Chamadreja/pps-solar-charger/investigacion/Bateria/eleccion de bateria.docx

Requerimientos: Se busca una batería robusta, de larga vida útil, siendo esta de almenos 500 ciclos, con el menor tiempo de carga posible. El Tamaño no es un factor decisivo, sin embargo, se valorará una dimensión reducida a fines de mejorar la estética y portabilidad. Se tendrá en cuenta el valor respecto de sus pares. Que provea una tensión de alimentación de al menos 5V y una capacidad de 10 ah o superior. Estos valores son considerados pensando en un escenario desfavorable, en el cual mi panel está inactivo por un tiempo prolongado y nuestra batería debe poder mantener el circuito funcionando (una estimación del mayor consumo es de 1.2 Ah). De esta forma nos aseguramos el funcionamiento de la estación base por una semana, considerando una batería llena sin alimentación externa. Es válido usar una configuración serie o paralela para poder cumplir con los requisitos. El Ah tiene una base de 20 hs.

A continuación, se expresa un cuadro comparando un promedio de las principales características que tienen los tipos de batería más conocidos

Tipo | Voltaje por elemento y corriente pilas tipo AA | Vida útil (n° recargas) | Densidad energía (Wh/Kg) | Tiempo de carga (horas) | observación
Acido plomo | 2 V | 1000 | 30-40 | 8-16 | Bajo costo No admiten sobrecargas ni descargas por debajo del 50% (reduce mucho la vida útil) Escalabilidad reducida para adjuntar nuevas baterias, en función de la configuración y tiempo de vida que tengan Eficiencia de carga entre 80% y 85 % No pueden funcionar acostadas Contaminan Requieren mantenimiento Peso excesivo
Níquel hierro (Ni-Fe) | 1.2 a 1.4 V | +10000 | 30-55 | 4-8 | Pésimo rendimiento (eficiencia de 65%) No tiene efecto memoria, lo que da una gran vida útil (superior a 100 años) Admite sobrecargas, repetidas descargas totales e incluso cortocircuitos sin pérdida significativa de capacidad
níquel-cadmio (Ni-Cd) | 1.2 V 0,5 a 1,0 A | 500 | 48-80 | 10-14 | Admiten un gran rango de temperaturas de funcionamiento. Admiten sobrecargas, se pueden seguir cargando cuando ya no admiten más carga, aunque no la almacenan. Efecto memoria muy alto. Densidad de energía baja.
níquel-hidruro metálico (Ni-MH) | 1,2 V 0,5 a 2,8 A | 1000 | 60-120 | 2-4 | Efecto memoria bajo No admiten bien el frío extremo, reduciendo drásticamente la potencia eficaz que puede entregar.
Litio (Li-ION) | máxima 4,3 V Nominal 3,6 baja 2,65 V (no es limitante) 1,5 a 2,8 A | 4000 | 110-160 | 2-4 | Mayor costo Enorme densidad energética, muy livianas, tamaño pequeño, Buen rendimiento, cercano al 100% Bajo efecto memoria Inflamables Facilidad para aumentar la capacidad o características eléctricas Muy sensibles a descarga completa instantánea Toleran un amplio rango de temperatura Tiempo de carga rápido No requieren mantenimiento Mantienen un voltaje estable al descargarse Vida útil de 3 años
Litio Ferrofosfato (LiFePO4) | Máximo 3.65 Nominal 3 Baja 2.5 V | 7000 o mas | 90 | 0.5 | Mantiene su voltaje constante mientras se descarga Liviana y compacta Mayor costo Buena durabilidad Destaca por su seguridad, usadas en aplicaciones medicas, aeronáuticas, etc
Litio (LiPo) | Máximo 4.2 V nominal 3,7 V y mínimo 3,0 V | 5000 | 100-130 | 1-1,5 | Mayor densidad de energía y mejor tasa de descarga, que LI-ION. Si se descargan por debajo del 30% (3V.) quedan inutilizables Baterias de celular Inflamables
Gel AGM | 1.6 – 1.8 V | 200 a 1000 | 40 ? | 10 | Son una batería de ácido plomo modificada, esta el electrolito se encuentra en un estado de gel o gaseoso Vida útil 12 años Sellamiento hermético, puede utilizarse en cualquier posición No requieren mantenimiento Soportan temperaturas extremas Voltaje variable en función de la carga Contaminan

El efecto memoria es un efecto no deseado que afecta a las baterías y por el cual en cada recarga se limita el voltaje o la capacidad (a causa de un tiempo largo, una alta temperatura, o una corriente elevada). La consecuencia es la reducción de su capacidad para almacenar energía.

Las baterías de níquel se pueden cargar hasta en 30 minutos, con cargas rápidas, pero disminuye su vida y se calientan en exceso, siendo las únicas que admiten este tipo de cargas.

Conclusión: Optamos por utilizar una batería plomo ácido de gel, también denominadas sla o vrla, debido a que presenta una buena vida útil respecto de sus pares, toleran un alto rango de temperaturas, lo cual es crucial ya que la capacidad de se ve fuertemente disminuida con la temperatura. Son robustas y cumplen con nuestros requerimientos eléctricos. Las baterías de litio fueron seriamente consideradas, debido a que presentan ventajas en números aspectos sobre, tales como tolerancia a las temperaturas, fiabilidad, posibilidad de escalabilidad, vida útil. Sin embargo, fueron descartadas debido a que su precio es considerablemente más elevado y su rango inferior de temperatura para ser cargada es un poco más alto.

Nombre -Fabricante | Distribuidor | Características | Precio En dólares | Datasheet
BGH-690F2 Battery guy | Digikey | 6V 9Ah AGM Temperatura carga sin especificar | 32 | https://batteryguy.com/files/technical-docs/tech-spec-sheets/bgh-690f2-technical-specification-sheet.pdf
BW 6140 Bright Way Group | Digikey | 6v 14 Ah AGM Temperatura carga -10° a 50° | 29 | https://media.digikey.com/pdf/Data%20Sheets/Bright%20Way%20Group/BWG_Spec_Sheet_BW%206140.pdf
PS-6100 Power Sonic | Digikey | 6v 12 Ah AGM Temperatura carga -15° a 50° | 28 | https://www.power-sonic.com/wp-content/uploads/2018/12/PS-6100%20technical%20specifications.pdf
BP33-6-B1 B B Battery | Digikey | 6V 33 Ah AGM Temperatura carga 0° a 40° | 120 | http://www.bb-battery.com/global/show.php?f=BP33-6.pdf.d8a36eda4faaf028dc24dfe75d7caaf6&m=BP33-6.pdf
BP10-6-T1 B B Battery | Digikey | 6V 10 Ah AGM Temperatura carga 0° a 40° | 17.5 | http://www.bb-battery.com/global/show.php?f=BP10-6.pdf.06ace2856471720bfb7fbd8f4346005c&m=BP10-6.pdf
PC12-6XBF1 Zeus Battery Products | Digikey | 5.25V 10 Ah AGM Temperatura carga 0° a 45° | No carga la página | https://www.zeusbatteryproducts.com/wp-content/uploads/downloads/ZEUS_SPEC_SHEET_PC12-6XB_RevV2.pdf
BW 6140 Bright Way Group | Digikey | 6V 14 Ah AGM Temperatura carga -10° a 50° | 29.7 | https://media.digikey.com/pdf/Data%20Sheets/Bright%20Way%20Group/BWG_Spec_Sheet_BW%206140.pdf

Electrocomponentes y elemon aparentemente no vende baterías o no estamos buscando bien
Mouse tiene disponibilidad, pero no arroja precios

Nombre -Fabricante | Distribuidor | Características | Precio En dólares | Datasheet
PRT-11856 Sparkfun Electronics | Digikey | 7.4 V 2.2 Ah | 15.95 | https://media.digikey.com/pdf/Data%20Sheets/Sparkfun%20PDFs/PRT-11856_Web.pdf
DTP605068-3P Sparkfun electronics | Digikey | 3.7V/ 6Ah Temperatura carga -0° a 45° | 29.95 | https://cdn.sparkfun.com/datasheets/Prototyping/spe-00-DTP605068-3P-6000mah-en-1.0ver.pdf
PRT-12895 SparkFun Electronics | Digikey | 3.7 V 2.6Ah Temperatura carga -0° a 45° | 5.95 | https://cdn.sparkfun.com/datasheets/Prototyping/ICR18650%202600mAH%20datasheet.pdf
PIS-1131 Pi Supply | Digikey | 3.7 V 5Ah Temperatura carga sin especificar | 43.66 | https://cdn.shopify.com/s/files/1/2187/3161/files/PIS-1131_5000mAh_PiJuice_Battery.pdf
BL2200F6034501S2PZAL GlobTek, Inc. | Digikey | 3.7 V 2Ah Temperatura carga 0° a 45 | 17 | https://www.globtek.com/pdf/manual-datasheets/BL2200F6034501S2PZAL.pdf
LI18650PBF 2S2P Jauch Quartz | Digikey | 7.2V 6.5AH Temperatura carga 0° a 45 | 51 | https://www.jauch.com/downloadfile/5bf56df1aa4563344c66752e0b062d553/6700mah_-_li18650jp_2s2p_2_wires_70mm.pdf
RJD3555HPPV30M Illinois Capacitor | Digikey | 3V 5Ah Temperatura carga 0° a 45 | 29 | https://media.digikey.com/pdf/Data%20Sheets/Illinois%20Cap/RJD_Series_Rev2016.pdf
LION-1865-34 Ultralast | Digikey | 3.7V 3.4AH Temperatura carga sin especificar | 12 | https://www.digikey.com/en/products/detail/ultralast/LION-1865-34/13692714
ICR18650 PKCELL | Digikey | 4.4Ah 3.7V Temperatura carga -0° a 45° | 20 | https://cdn-shop.adafruit.com/product-files/354/C449_-_ICR18650_4400mAh_3.7V_with_PCM_20140728_APPROVED_8.18.pdf

Se elige la batería PS-6100 de Power Sonic debido a que tolera cargas en temperaturas inferiores a la de sus pares. Este factor es determinante ya que en zonas, no muy lejanas a Bariloche, las temperaturas pueden llegar fácilmente a -20°C o incluso menos.

En cuanto a las temperaturas de operación, se prevé diseñar algún sistema de refrigeración cuando estas estén llegando al máximo descrito por el fabricante, mientras que para solventar aquellas situaciones donde la temperatura esté por debajo del margen tolerable, contaremos con cierta estructura que aislará nuestro circuito del medio, además de que cuando el panel comienza a recibir energía solar, se supone que se ganaron algunos grados de temperatura comparados con los mínimos registrados.
