Chamadreja/pps-solar-charger/investigacion/Cargador/subsistema carga bateria.docx

Previamente en el informe global deberá estar definido, zona de operación, tiempo de funcionamiento y alguna otra característica que no se me viene a la mente en el momento

introducción al subsistema

Este subsistema es de crucial importancia, debido a que si este falla o no funciona correctamente, todos los otros subsistemas fallaran.

Se prevé diseñarlo a partir de tres componentes, siendo estos: batería, cargador y un panel solar.

La batería estará alimentando la totalidad de la estación base de forma continua. El cargador será responsable de monitorear la capacidad de la misma y gestionar su carga de manera correcta, a través de la energía provista por un panel solar, aunque también será posible realizar la carga mediante otro suministro eléctrico, como la corriente de red.

Para elegir los componentes se utilizó la misma metodología en todos, siendo esta, definir los requisitos que deben cumplir en primera instancia. Luego realizar una investigación sobre las distintas clases de componentes que existen, para realizar una buena elección utilizamos un sistema de puntuación. Una vez definida la clase, se realizó un estudio de mercado sobre los distintos productos que ofrecen los principales distribuidores. Finalmente, sobre estos, se realizó una nueva elección, en busca del componente optimo par nuestro proyecto

Batería

Requerimientos: Se busca una batería robusta, de larga vida útil, siendo esta de al menos 400 ciclos, con el menor tiempo de carga posible. El tamaño no es un factor decisivo, sin embargo, se valorará una dimensión reducida a fines de mejorar la estética y portabilidad. Que posea un rango de temperatura de acorde a línea sur. Se tendrá en cuenta el valor monetario respecto de sus pares. Que provea una tensión de alimentación de al menos 5V y una capacidad de 10 Ah o superior. Es válido usar una configuración serie o paralela para poder cumplir con los requisitos.

Acerca de los valores de temperatura, la temperatura de carga, siempre es menor que la temperatura de operación. Por lo tanto, esta es la limitante y en la cual nos basaremos. En la línea sur se registran temperaturas entre -30 °C y 35 °C grados. Decidimos que una temperatura de carga entre -10 °C y 40 °C será suficiente, si bien no cumplimos con la mínima. Esto no será un problema, debido a que nuestro sistema de carga funcionara cuando salga el sol, esto significa que la temperatura ambiente subirá unos grados respecto de la mínima, además estará al resguardo de la intemperie y el propio calor generado a partir del funcionamiento aumentaran aún más la temperatura.

Los valores eléctricos son definidos a partir de la tensión necesaria para el correcto funcionamiento de todos los componentes eléctricos y bajo la posibilidad de un escenario desfavorable, en el cual no se dispone de energía para cargar la batería por un tiempo prolongado y esta debe mantener el circuito funcionando

Una estimación del mayor consumo posible es la estación base es de 1.1 Ah. Por lo tanto, aseguramos el funcionamiento de la estación base por al menos 9 días, considerando una batería llena sin alimentación externa. En la tabla 4 y tabla 5 quedan detallados los consumos de cada componente

Cabe destacar que estos valores son aproximados, debido a que es algo teórico y no sabe a ciencia cierta el protocolo de comunicación que será utilizado, además de que las baterías pierden tensión en función de su carga. Realmente la batería está sobredimensionada, debido a que nunca tendremos nuestra estación base operando a toda su capacidad por periodos prolongados de tiempo, lo que significa que en verdad podremos funcionar todavía más tiempo, sin recargar la batería

Según la bibliografía el Ah tiene distintas bases de tiempo, tomaremos una de 20 hs en nuestro caso. Esto significa que una batería de 1 Ah tiene la capacidad de proveer 1 A durante 20 horas

Componente | consumo nominal (mAh) | Voltaje de operación típico (V) | Corriente Máxima (mA) | Vida útil (años)
módulo ESP 32 W-ROOM | 40 | 3.6 | 1200 | 12
SIM 800L | Reposo: 0.7 Transmisión: 500 | 4 | 500 | 4
módulo LoRa a definir | Reposo: 1.5 Recepción: 11.5 | 3.3 | transmisión 120 | 4.5
GPS NEO-6M | 30 | 3.3 | 100 | sin especificar
Totales y máximos | promedio 83 | máximo 4 V | máximo 1920

Tabla 4

El consumo máximo es irreal, debido a que nuestra estación base, jamás requerirá que el esp32 opere al 100%, a la vez que transmite datos con mediante el SIM800l y el GPS. Por lo tanto, se realizaron cuentas en base a un caso máximo real

Descripción | Consumo (mA)
Tranmision SIM800l | 500
Tranmsiion GPS 6M-NEO | 100
Funcionamiento y recepción LoRa | 11.5
Funcionamiento ESP32 W-ROOM con WIFI y BLE activados | 390
Sistema de carga | 100
TOTAL | 1101.5

Tabla 5

Elección tipo de batería

En la tabla 6 se comparan los principales tipos de baterías

Tipo | Voltaje por elemento y corriente pilas tipo AA | Vida útil (n° recargas) | Densidad energía (Wh/Kg) | Tiempo de carga (horas) | observación
Acido plomo | 2 V | 1000 | 30-40 | 8-16 | Bajo costo No admiten sobrecargas ni descargas por debajo del 50% (reduce mucho la vida útil) Escalabilidad reducida para adjuntar nuevas baterías, en función de la configuración y tiempo de vida que tengan Eficiencia de carga entre 80% y 85 % No pueden funcionar acostadas Contaminan Requieren mantenimiento Peso excesivo
Níquel hierro (Ni-Fe) | 1.2 a 1.4 V | +10000 | 30-55 | 4-8 | Pésimo rendimiento (eficiencia de 65%) No tiene efecto memoria, lo que da una gran vida útil (superior a 100 años) Admite sobrecargas, repetidas descargas totales e incluso cortocircuitos sin pérdida significativa de capacidad
níquel-cadmio (Ni-Cd) | 1.2 V 0,5 a 1,0 A | 500 | 48-80 | 10-14 | Admiten un gran rango de temperaturas de funcionamiento. Admiten sobrecargas, se pueden seguir cargando cuando ya no admiten más carga, aunque no la almacenan. Efecto memoria muy alto. Densidad de energía baja.
níquel-hidruro metálico (Ni-MH) | 1,2 V 0,5 a 2,8 A | 1000 | 60-120 | 2-4 | Efecto memoria bajo No admiten bien el frío extremo, reduciendo drásticamente la potencia eficaz que puede entregar. Unicas q
Litio (Li-ION) | máxima 4,3 V Nominal 3,6 baja 2,65 V (no es limitante) 1,5 a 2,8 A | 4000 | 110-160 | 2-4 | Mayor costo Enorme densidad energética, muy livianas, tamaño pequeño, Buen rendimiento, cercano al 100% Bajo efecto memoria Inflamables Facilidad para aumentar la capacidad o características eléctricas Muy sensibles a descarga completa instantánea Toleran un amplio rango de temperatura Tiempo de carga rápido No requieren mantenimiento Mantienen un voltaje estable al descargarse Ante descarga profunda, se recuperan suministrando corriente constante durante la primer etapa y a voltaje constante durante toda la carga Vida útil de 3 años
Litio Ferrofosfato (LiFePO4) | Máximo 3.65 Nominal 3 Baja 2.5 V | 7000 o más | 90 | 0.5 | Mantiene su voltaje constante mientras se descarga Liviana y compacta Mayor costo Buena durabilidad Destaca por su seguridad, usadas en aplicaciones médicas, aeronáuticas, etc
Litio (LiPo) | Máximo 4.2 V nominal 3,7 V y mínimo 3,0 V | 5000 | 100-130 | 1-1,5 | Mayor densidad de energía y mejor tasa de descarga, que LI-ION. Si se descargan por debajo del 30% (3V.) quedan inutilizables Baterias de celular Inflamables
Gel AGM | 1.6 – 1.8 V | 200 a 1000 | 40 ? | 10 | Son una batería de ácido plomo modificada, el electrolito se encuentra en un estado de gel o gaseoso Vida útil 12 años Sellamiento hermético, puede utilizarse en cualquier posición No requieren mantenimiento Soportan temperaturas extremas Voltaje variable en función de la carga Contaminan Ante descarga profunda, debe recuperarse respetando los ciclos de carga

Tabla 6

Referencia para entender la tabla, lo deberíamos poner? De ser asi, como ¿

El efecto memoria es un efecto no deseado que afecta a las baterías y por el cual en cada recarga se limita el voltaje o la capacidad (a causa de un tiempo largo, una alta temperatura, o una corriente elevada. La consecuencia es la reducción de su capacidad para almacenar energía.

Conclusión: Optamos por utilizar una batería plomo ácido AGM, también denominadas sla o vrla, debido a que presenta una buena vida útil respecto de nuestros requerimientos, tiene uno de los mayores rango de temperatura para una carga correcta , lo cual es crucial para mantener mi sistema funcional. Son robustas y cumplen con nuestros requerimientos eléctricos. Un detalle negativo de estas, es que el voltaje varía en función de la capacidad de la misma, es por esto que usaremos una batería cuyo voltaje sea superior a los que requiere mi circuito, a modo de compensar la caída de tensión. Respecto al tiempo de carga no parece ser el mejor en las tablas, sin embargo, considerando que, para lograr una misma capacidad con otras baterías, por ejemplo, de ION-litio debo configurar varias de ellas en paralelo, el tiempo de carga individual se verá aumentado en función de la cantidad de baterías que tenga, lo que resulta en tiempos de carga similares

Las baterías de litio fueron seriamente consideradas, debido a que presentan ventajas en números aspectos sobre las AGM, tales como fiabilidad, posibilidad de escalabilidad y vida útil. Sin embargo, fueron descartadas debido a que su precio es aproximadamente el doble, un promedio de 60 dólares contra 30 de las AGM para lograr la misma capacidad. También debido a que no toleran temperaturas tan bajas como las AGM

A continuación, se expresa una comparación entre los distintos modelos de baterías AGM que fueron considero para el proyecto.

Nombre -Fabricante | Distribuidor | Características | Precio En dólares | Datasheet
BGH-690F2 Battery guy | Digikey | 6V 9Ah AGM Temperatura carga sin especificar | 32 | https://batteryguy.com/files/technical-docs/tech-spec-sheets/bgh-690f2-technical-specification-sheet.pdf
BW 6140 Bright Way Group | Digikey | 6v 14 Ah AGM Temperatura carga -10° a 50° | 29 | https://media.digikey.com/pdf/Data%20Sheets/Bright%20Way%20Group/BWG_Spec_Sheet_BW%206140.pdf
PS-6100 Power Sonic | Digikey | 6v 12 Ah AGM Temperatura carga -15° a 50° | 28 | https://www.power-sonic.com/wp-content/uploads/2018/12/PS-6100%20technical%20specifications.pdf
BP33-6-B1 B B Battery | Digikey | 6V 33 Ah AGM Temperatura carga 0° a 40° | 120 | http://www.bb-battery.com/global/show.php?f=BP33-6.pdf.d8a36eda4faaf028dc24dfe75d7caaf6&m=BP33-6.pdf
BP10-6-T1 B B Battery | Digikey | 6V 10 Ah AGM Temperatura carga 0° a 40° | 17.5 | http://www.bb-battery.com/global/show.php?f=BP10-6.pdf.06ace2856471720bfb7fbd8f4346005c&m=BP10-6.pdf
PC12-6XBF1 Zeus Battery Products | Digikey | 5.25V 10 Ah AGM Temperatura carga 0° a 45° | 23 | https://www.zeusbatteryproducts.com/wp-content/uploads/downloads/ZEUS_SPEC_SHEET_PC12-6XB_RevV2.pdf
BW 6140 Bright Way Group | Digikey | 6V 14 Ah AGM Temperatura carga -10° a 50° | 29.7 | https://media.digikey.com/pdf/Data%20Sheets/Bright%20Way%20Group/BWG_Spec_Sheet_BW%206140.pdf
UL 12-6 ultracell | electrosistemas | 6V 12 Ah AGM Temperatura carga 0° a 40° | 13.1 | http://www.electrosistemas.com.ar/datasheets/ultracell/UL12-6.pdf

Electrocomponentes y elemon aparentemente no vende baterías o no estamos buscando bien
Mouse tiene disponibilidad, pero no arroja precios

Estas son de litio, fueron consideras fuertemente, deberíamos poner el cuadro a modo de comparación o lo sacamos directamente ¿

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

Para elegir qué tipo de batería es más adecuada utilizamos una escala del 1 al 5, quedando descrita el peso de cada una en la tabla 7, aquellas características que no cumplen con los requisitos o no están especificadas, sumaran un puntaje nulo:

-5 un requisito fundamental e indispensable

-4 un requisito que afecta las características del proyecto, pero se podría usar

-3 un requisito que se debe considerar, pero no es indispensable

-2 tiene muy poca influencia en nuestro proyecto

-1 no posee influencia en el proyecto

Características | Descripción | Valoración de la característica (del 1 al 5)
Tensión Nominal | 5 V o superior | 5
Capacidad | 10Ah o superior | 5
Vida útil en años | más de 5 | 4
Ciclos de carga | 400 o superior | 4
Temperatura de carga | -10°C a 40°C o superior | 4
Precio | Inferior a 50 dólares | 3
Portabilidad | Simple o moderada | 2

Deberíamos poner portabilidad, ciclos de carga y vida útil en la tabla? Para poder comparar ¿

Tabla 7

Resultados de la valoración

Batería | Puntaje
BGH-690F2 de Battery guy | 18
BW 6140 de Bright Way Group | 27
PS-6100 de Power Sonic | 27
BP33-6-B1 de B B Battery | 19
BP10-6-T1 de B B Battery | 24
PC12-6XBF1 de Zeus Battery Products | 23
BW 6140 de Bright Way Group | 27
UL 12-6 de Ultracell | 23

Decisión sobre el modelo de batería a usar

Se elige la batería PS-6100 de Power Sonic sobre aquellas que sumaron el mismo puntaje debido a que tolera temperaturas de carga inferiores a la de sus pares. Además de que posee un menor precio

Quedo muy escueto?

Cargador de batería

Se encarga de llenar nuevamente la batería cuando esta se encuentra por debajo de cierto nivel, con energía provista por el panel solar u otra fuente externa.

Como la potencia del panel no es siempre la misma y a su vez la energía requerida por la batería tampoco es siempre igual, sino que depende del estado de carga en que se encuentre, debemos asegurarnos de controlar estas variables, para un correcto funcionamiento de nuestro circuito y además prolongar su vida útil

Los requerimientos que se deben cumplir son:

-Evitar que la batería se descargue por debajo del 50% mientras se cuente con energía para cargarla

-Realizar ciclos de carga completos para baterías AGM, respetando los niveles de voltaje y amperaje en función del ciclo de carga. Se valorará que pueda cargar otro tipo de baterías

-Proteger la batería contra sobrecargas

-evitar que la batería se pueda descargar de noche en el campo fotovoltaico por inversión de corriente

-Facilidad de integración en un pcb

-Eficiencia para poder aprovechar la mayor energía posible

-Temperatura de operación de al menos entre -10°C y 40°C

-Posibilidad de ser alimentado con panel solar y otra fuente

-Rango de salida de 6V y 2A o superior

-Rango de entrada de acuerdo a los valores provistos por el panel solar, (18V) nose como escribirlo, todavía no definí el panel, como voy a decir los valores ¿

No es un requisito indispensable, sin embargo, se valorará que posea alguna interfaz para conocer los datos internos de la batería, como temperatura y nivel de carga. A fin de tener una posible escalabilidad en nuestro proyecto. También se tendrá en cuenta la posibilidad de manejar registros internos del IC para tener un mayor control del mismo

Fases de carga para una batería AGM esta bien ponerlo aca o lo pongo en la sección de la bateria ¿

• Carga Masiva (bulk) consiste en cargar con una corriente (I) constante hasta 80 a 90% de la capacidad de la batería. Mientras que el voltaje va aumentando gradualmente.

En esta etapa el regulador que se sitúa entre el panel y el acumulador no juega ningún papel, debido a que la corriente se suministra a intensidad máxima, pero sin él la fase Bulk sería permanente y la corriente proveniente de los paneles podría destruir la batería por sobrecarga.

•Absorción se emplea un voltaje constante (Uo), un poco más elevado que el proporcionado por la batería, durante un tiempo limitado (2 a 4 hs) hasta casi alcanzar 100%. Esta fase se termina cuando la corriente se reduce por el aumento de la resistencia interna de la batería. La finalidad de esta etapa es recuperar el electrolito

•Flotación: se reduce a la tensión Uo hasta la tensión de flotación, la corriente inyectada se reduce hasta que la batería se llena por completo. Proporciona la corriente necesaria para compensar la auto descarga, de manera que permanezca al 100%, las baterías de gel pueden ser dejadas en fase de flotación durante periodos largos sin problemas

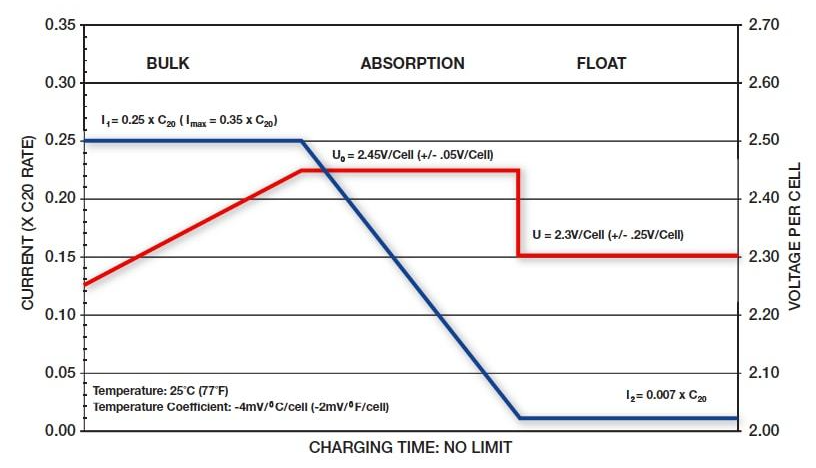
[picture p29: figure]

Existen cargadores con fases adicionales como:

- una fase para la ecualización para baterías liquidas con el fin de eliminar una estratificación (una ligera sobrecarga controlada que se aplica cada 3 a 6 meses),
- una pulsación después de la fase de flotación para reducir la sulfatación,
- iniciar una carga con poco voltaje para tratar recuperar baterías profundamente descargadas.

Existen dos tipos de cargadores

PWM (Pulse-Width Modulation): Son los más antiguos. La tensión de trabajo de las placas solares es la misma que la de la batería en todo momento, estas son cargada de forma gradual con pulsos de tensión que varían de ancho, la corriente se va introduciendo poco a poco hasta que la batería se llena de manera óptima y estable. Es por esto que los paneles no trabajan en su punto de máxima potencia, provocando una perdida alrededor del 30%. Son los más económicos.

MPPT (Maximum Power Point Tracking): Compuesto por un convertidor de tensión CC-CC y un seguidor del punto de máxima potencia. Puede trabajar a diferentes potencias en el campo fotovoltaico y en las baterías, logrando una mayor eficiencia. Es especialmente útil también en momentos de sombreados parciales debido a la nubosidad temporal. Gracias al limitador de corriente, la potencia de salida nunca excederá el máximo de la del controlador. Permite trabajar con paneles dispuestos en serie o paralelos

Se concluye que debemos usar un cargador de tipo MPPT debido a su mayor eficiencia, posibilidad de escalabilidad en los paneles solares y prestaciones extras para el cuidado de la batería, tales como limitar la corriente de salida máxima.

Para nuestra elección se tuvieron en cuenta los siguientes modelos

Marca | LTC4162_S | BQ34Z110 | BQ78412 | BQ76200
Fabricante | Analog Devices | Texas Instrument | Texas Instrument | Texas Instrument
Distribuidor | Mouser | Digikey | Mouser | Digikey
Datasheet | https://ar.mouser.com/datasheet/2/609/LTC4162_S-1398197.pdf | https://www.ti.com/lit/ds/symlink/bq34z110.pdf?HQS=dis-dk-null-digikeymode-dsf-pf-null-wwe&ts=1622675428667 | https://rocelec.widen.net/view/pdf/5zpsdeimfl/bq78412.pdf?t.download=true&u=5oefqw | https://www.ti.com/lit/ds/symlink/bq76200.pdf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
Precio en dólares | 6.9 | 15 | 15 | 17
Tensión de entrada | 4.5V a 45V | Sin especificar | 4V a 26V | 8V a75V
Montaje | SMD | SMD | SMD | SMD
Interfaz de datos | I2C | I2C HDQ Single Wire | UART Serial Interface Opcional Infra-Red Display LED | Display LED por I2C
Consumo | 100 uA | Normal: < 140 uA Sleep: <64 uA Full Sleep: < 19uA | Normal: < 3.2mA | Normal: 40uA Shutdown: 10uA
Ciclos de carga | Respeta ciclos de carga para baterías AGM y Litio | Los ciclos de carga deben ser configurados por el usuario | Se ajusta a cada batería junto con el compensador de temperatura | Respeta un único ciclo de carga Constante ¿
Temperatura de Operación | -40°C a 145°C | -40°C a 85°C | -45°C a 85°C | -40°C a 110°C
Apto para panel solar | Si | Sin Especificar | Sin Especificar | Sin Especificar
Manejos de registros | Totalmente controlable y ajustable por registros | Totalmente ajustable y controlable por registros | Totalmente controlable y ajustable por registros. | Parece ser de propósito general y no modificable
Voltaje de Salida | 6V -12V -18V- 24V | 4V - 64V | 12V | 0V A 100V recomendada de 0 a 75)
Corriente máxima de salida | 3.2A | >32A | 16A | Sin especificar

Se aborda una valoración, utilizando la misma escala de la batería y considerando los siguientes aspectos

Características | Descripción | Valoración de la característica
Voltaje de Entrada | > 18V | 5
Tipo de montaje | Superficial | 5
Temperatura de operación | –10°C a 60°C o superior | 5
Apto para panel solar | Debe ser apto para panel solar | 5
Voltaje de Salida | 6V a 12V | 5
Corriente de Salida | Mínimo 2A | 5
Ciclo de carga | Realizar Fases de carga AGM | 4
Consumo | <100mA | 3
Precio | <10 dolares | 2
Salida de datos | I2C o cualquier panel LED | 1

Resultados valoración

Cargador | Puntaje
LTC4162_S de Analog Devices | 40
BQ34Z110 de Texas Instrument | 28
BQ78412 de Texas Instrument | 33
BQ76200 de Texas Instrument | 24

Conclusión: Se elige el regulador LTC4162-S debido a que cumple ampliamente nuestros requisitos, es totalmente configurable y tolera perfectamente la potencia producida por el panel, pudiendo regularla para cargar de forma correcta nuestra batería. Además de que tiene un precio considerablemente menor. Es el único que posee pruebas realizadas con paneles solares por lo tanto podemos asegurarnos de que funcionara correctamente. También es notable la gran escalabilidad debido a que es posible adquirir datos de temperatura, carga de batería, el resto que no me acuerdo cuales son y obtenerlos vía i2c

Panel solar

Los paneles solares tienen una eficiencia baja, entre 15% y 25%, esto significa que cada 1000 W que provee el sol, solo se podrán utilizar 150 W. Estos pierden potencia cuando son sometidos a altas temperaturas

Se sabe que el sol no siempre emite la misma potencia, tomando los casos extremos tenemos que en verano provee un máximo de 1100 w/m2, mientras que en la estación invernal puede alcanzar solamente los 600 w/m2. Como tener un exceso de potencia no significa un riesgo para nuestro circuito, mientras que tener una ausencia si lo es, se realizara la elección en base al peor caso posible.

Requerimientos

Para nuestro proyecto no tenemos problemas de dimensión ni de peso, por lo tanto, se prioriza un bajo precio para la elección antes que una gran eficiencia. El mismo debe poder proveer una corriente entre 2A y 3A los cuales son necesarios para la primera fase de carga de mi batería. Además de una tensión superior a 8V, para esta elección se consideró el voltaje requerido por los ciclos para realizar una correcta carga de la batería, además de las pérdidas generadas por el regulador de carga LTC4162-S (tiene una eficiencia del 92 % aproximadamente)

Antes de elegir un panel debemos conocer los distintos tipos que existen

Fotovoltaico: compuestos por células fotovoltaicas de silicio a través de un proceso llamado efecto fotoeléctrico, permiten transformar la energía lumínica en energía eléctrica.

Este proceso se da cuando los fotones provenientes del sol impactan sobre el panel solar, concretamente, contra el silicio del que está compuesto, estos liberan electrones que serán los encargados de generar una corriente eléctrica

A su vez existe otra clasificación, en función de cómo están compuestas las células fotovoltaicas

-amorfo: su nombre viene de la forma que toma el silicio, poseen un color marrón, tienen la peor densidad de potencia y por lo tanto el peor rendimiento, se degrada mucho con los años, son los más económicos.

-Monocristalinos: fueron los primeros en ser fabricados, necesitan silicio de alta pureza (99.99%) para lograr cristales de forma redonda, que se corta para armar el panel, por eso se notan las “estrellas” en las intersecciones, tienen la mayor eficiencia en condiciones estándar (18% al 20%) pero son más costosos, poseen un color oscuro

-Policristalinos: compuestos de varias celular cuadradas, esto permite un mayor acomodo ahorrando espacio en el módulo, de color azulado, con eficiencia entre el 16% al 18%, son más baratos que los monocristalinos y toleran mejor las altas temperaturas.

-Cuasi-mono: combinando el sistema de fabricación lenta de célula monocristalina pero utilizando un control cuidadoso de la orientación del cristal con lo cual se obtiene una célula monocristalina con partes de célula policristalina

Capa fina (thin film): pueden estar compuestos por cobre, indio y selenio (CIS) o de cobre, indio, galio y selenio (CIGS), cadmio y telurio (CdTe). Su rendimiento es muy bajo, en torno al 8%, sin embargo, son muy baratos y tienen un buen comportamiento frente a las altas temperaturas Orgánicos: diseñados con derivados del carbono, son delgados, plegables, eficiencia entre 10% y 15%, baja durabilidad, menor precio que las de silicio, menos pesadas, flexibles y transparentes

Térmico: transforman la energía procedente del sol en energía térmica, son utilizados en climatización de piscinas, calentamiento de agua, creación de vapor. En función de la temperatura que producen existe una nueva clasificación

Hibrido: son una mezcla de un panel fotovoltaico junto a uno térmico. Con las 2 tecnologías aunadas en un sólo panel, este tipo de tecnología permite producir electricidad y calor simultáneamente.

También cabe destacar el uso de algunas tecnologías abocadas a mejorar la eficiencia

Perc: agregan una capa reflectante, de esta forma la célula absorbe más energía y logra una temperatura más baja. También logra una mejor conducción de los electrones ganando eficiencia

Bifaciales: pueden producir energía de ambos lados, mayor vida útil, utilizan células monocristalinas o policristalinas

Conclusión: consideramos que un panel solar policristalino común será la mejor elección para nuestra estación base, debido a tolerar mejor las altas temperaturas, ofrece una buena relación entre la eficiencia y su precio, además de una larga vida útil

Modelo | Distribuidor | Características | Precio (dolares) | Datasheet
Ec-20w-12 | Digikey | Potencia nominal: 20w Cantidad celdas: 36 Tension a pot max: 17.2 V Corriente a pot máx: 1.16 A Temperatura Op: -40°C a +85°C Dimensiones: 520 mm x 360 mm Peso: 2.3 kg Eficiencia ¿ | 37 | https://electrocomponentes.com/tienda/energia-solar/paneles/panel-solar-fotovoltaico-20w-policristal
Ec-40w-12 | Digikey | Potencia nominal: 40w Cantidad celdas: 18 Tension a pot max: 17.2 V Corriente a pot máx: 2.32 A Temperatura op: -40°C a +85°C Dimensiones: 630 mm x 530 mm Peso: 4.1kg Eficiencia ¿ | 65 | https://electrocomponentes.com/tienda/energia-solar/paneles/panel-solar-fotovoltaico-40w-policristal
Ec-60w-12 | Digikey | Potencia nominal: 60w Cantidad celdas: 36 Tension a pot max: 17.2 V Corriente a pot máx: 3.49 A Temperatura op: -40°C a +85°C Dimensiones:700mm x 670mm x 30mm Peso: 5.7 kg Eficiencia ¿ | 82 | https://electrocomponentes.com/tienda/energia-solar/paneles/panel-solar-fotovoltaico-60w-policristal
KD50SE-1P de kyocera | Solarpanelsonline | Potencia nominal: 50 w Cantidad celdas: 36 Tension a pot max: 17.9 V Corriente a pot máx: 2.8 A Temperatura op:? Dimensiones:706 mm x 744 mm Peso: 6.5kg Eficiencia 9.5% | 99 | https://www.technosun.com/descargas/KYOCERA-KD50SE-1P-ficha-ES.pdf
KD70SX-1P de kyocera | Raisystems | Potencia nominal: 70 w Cantidad celdas: 36 Tension a pot max: 15.8 V Corriente a pot máx: 3.13 A Temperatura op:? Dimensiones:778 mm x 660 mm Peso: 6.5 kg Eficiencia 13.6% | 260 | https://www.technosun.com/descargas/KYOCERA-KD70SX-1P-ficha-ES.pdf
180 KS40 de SOLARTEC | Villanueva | Potencia nominal: 40 w Cantidad celdas: 36 Tension a pot max: 15.2 V Corriente a pot máx: 2.62 A Temperatura op: ¿ Dimensiones: ¿ Peso: 2.3 kg Eficiencia 14% | 58 | https://www.villanueva.com.ar/paneles-solares/1218-generador-solar-180-ks40-solartec-232011.html
eos-p50 de eosenergia | Eosenergia | Potencia nominal: 50 w Cantidad celdas: ¿ Tension a pot max: 17.8 V Corriente a pot máx: 2.95 A Temperatura op: -40°C a +85°C Dimensiones:670 mm x 540 mm x 30mm Peso: 5kg Eficiencia 17% | 51 | https://www.eosenergia.com.ar/web/productos/verproducto?idProducto=60
SPP 040451200 de Victron energy | Solarmat | Potencia nominal: 45 w Cantidad celdas: 36 Tension a pot max: 19.1V Corriente a pot máx:2.36A Temperatura op: -40°C a +85°C Dimensiones:425 mm x 668 mm x 25mm Peso: 3.1kg Eficiencia 11.9% | 89 | https://www.victronenergy.com.es/upload/documents/Datasheet-BlueSolar-Polycrystalline-Panels-ES.pdf

Otra vez se vuelve a usar la escala previamente mencionada, los aspectos que se valorarán serán:

Características | Descripción | Valoración de la característica
Corriente máxima | >2 A revisar este numero, ya tuve en cuenta las perdidas ¿ | 5
Tensión máxima | >6V | 5
Temperatura de operación | -30°C a 35°C | 5
Precio | <100 dólares | 4
Eficiencia | >10% | 2

Resultados de la valoración

Panel | Puntaje
Ec-20w-12 | 14
Ec-40w-12 | 19
Ec-60w-12 | 19
KD50SE-1P de kyocera | 14
KD70SX-1P de kyocera | 17
180 KS40 De SOLARTEC | 16
eos-p50 de eosenergia | 21
SPP 040451200 de Victron energy | 21

Conclusión: Se elige el panel eos-50 de eosenergia, debido a que es aquel que posee una corriente más cercana, sin sobrepasar, a la máxima que tolera nuestra batería. Cumple con los requisitos de tensión. Tiene la mayor eficiencia y el precio más bajo.
