Chamadreja/pps-solar-charger/investigacion/1___Cargador.pdf

# Cargador

## PPS - Cerco virtual

## Matias Ariel Ramirez y Fabio Vidal

29 de junio de 2024

## Índice

1. Introducción | 3
2. Requisitos | 3
3. Controlador | 6
4. Componentes | 9
5. Circuitos adicionales | 20
6. Diseños final propuesto | 23
7. Elección de componentes | 34
8. Fallas | 35

9. Circuito enfriador | 37
10. Bibliografía | 38

## 1. Introducción

En esta sección se realizara la elección y diseño de un cargador para las baterías que elegimos en la sección anterior, que deberá de cargarse mediante energía solar y la posibilidad de otra forma.

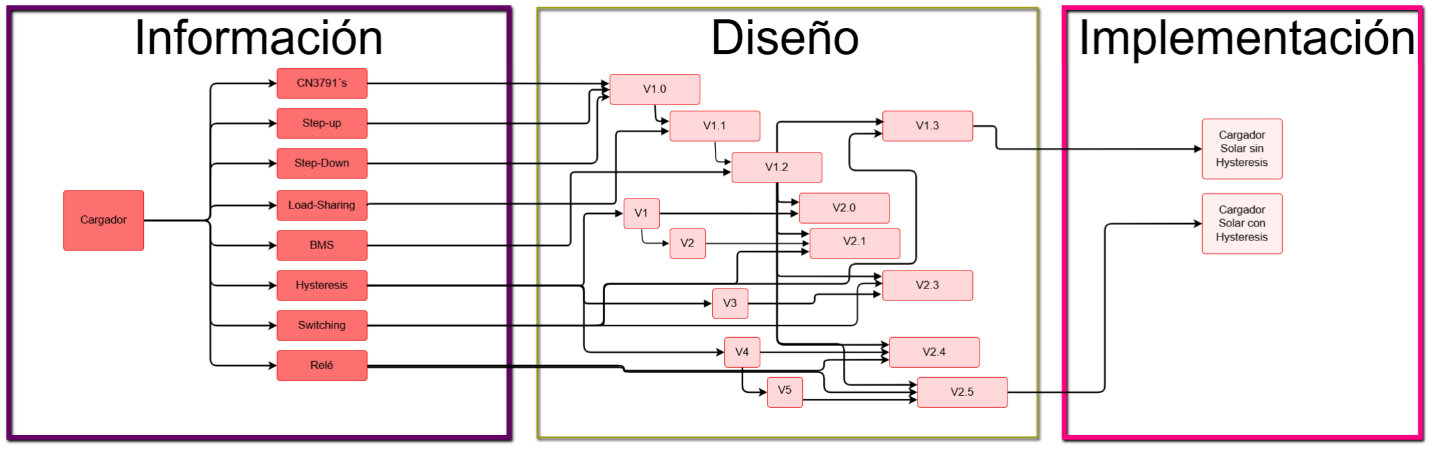
[picture p53: figure]

Figura 1: Diagrama de bloques sobre el cargador.

## 2. Requisitos

A continuación, se listan los parámetros eléctricos de los módulos propuestos por Denis Heredia y Sebastián Busch en su tesis “Estación base LoRa para sistemas de alambrado virtual”, extraídos de sus respectivas hojas de datos.

### 2.1. Módulo LoRa: RFM95

Símbolo | Descripción | Mín | Máx | Unidad
VDDop | Voltaje de Alimentación | 1.8 | 3.7 | V
Top | Rango operacional de temperatura | -20 | +70 | °C
Clop | Capacitancia de carga de puertos digitales | - | 25 | pF
ML | Nivel de Entrada RF | - | +10 | dBm

Cuadro 1: RFM95 (Tabla 50: Rango Operativo pp.12).

### 2.2. ESP32

Símbolo | Mín | Típico | Máx | Unidad
VBAT | - | - | 4.5 | V
Corriente | 0 | - | 2.0 | A
VBUS | - | - | 30 | V
II* (digital) | - | - | 38 | mA
IO*(digital) | - | - | 8 | mA

Cuadro 2: GSM: SIM800L. (Tabla 41: Valores Máximos Absolutos, pp.58)

Tabla de la pp.60 indica que requiere un voltaje típico de 4.0V, lo cual consume 0.8W para un consumo de 200mA. Pero, durante la ráfaga de transmisión, que consume 2A, ¿Se eleva el consumo de potencia de 9W?

### 2.3. GPS: NEO-6M

Símbolo | Parámetro | Mín | Típico | Máx | Unidad
VCC | Alimentación | 2.7 | 3.0 | 3.6 | V
Iccp | Máxima corriente de alimentación | - | - | A | V
Icc Tracking (max) | Corriente media | - | - | 39 | mA
Icc Tracking (Eco mode) | Corriente media | - | 37 | - | mA
Icc Tracking (Power save) | Corriente media | - | 11 | - | mA
Icc Adquisición | Corriente media | - | 47 | - | mA

Cuadro 3: NEO-6M (de Tabla 3.2: Condiciones Operativas y Tabla 3.3: Requerimientos de potencia indicativos, ambas en pp.15).

El mayor requerimiento de voltaje lo posee el módulo de GSM, con un máximo para la alimentación de 4.5V (si bien los valores en las condiciones operativas recomendadas especifican un mínimo de 3.4V, un máximo de 4.4V y un valor típico de 4.0V).
Los consumos promedios de corriente, de acuerdo con la tesis, son los siguientes:

### 2.4. Consumos

### 2.4.1. Originales

Descripción | Consumo mínimo (mA) | Consumo nominal (mA) | Consumo máximo (mA) | Voltaje (V)
ESP32 W-ROOM | 20 | 120 | 260 | 2.7 - 3.6
SIM800L | 0.7 | 350 | 2000 | 3.4 - 4.4
LoRa SXX 1276 (transmisión) | 20 | 87 | 120 | 1.8 - 3.7
GPS NEO-6M | 11 | 47 | 67 | 3.0 - 5.0
TOTAL | 51.7 | 574 | 2447 | 3.3

Cuadro 4: Consumos máximos (el SIM 800L esta sujeto a cambios).

Descripción | Consumo (mA)
Transmisión SIM800L | 0.7
Transmisión GPS NEO-6M | 11
Funcionamiento y Recepción LoRa | 87
Funcionamiento ESP32 W-ROOM con WIFI y BLE activados | 120
TOTAL | 218.7

Cuadro 5: Consumos promedios estimados.

Con estos datos en cuenta, y con el fin de que la estación tenga una autonomía de aproximadamente dos días, la tesis propone varias características a cumplir por la batería:

Robusta y de larga vida útil (al menos 400 ciclos de carga).

Dimensiones reducidas, en lo posible.

Rango de temperatura acorde a la zona de operación.

Bajo coste.

Tensión de al menos 5V.

Capacidad de 10000mAh o superior.

La tesis propone una batería de plomo ácido AGM, pero aquí se explorarán otras opciones, en particular las baterías de iones de litio, comúnmente denominadas Li-Ion.
También se explorarán distintas opciones para cargadores, haciendo énfasis en lo económico, pero no por ello dejando de lado la seguridad y fiabilidad.

### 2.4.2. Cambio de requisitos

Tras unos cambios en la siguiente etapa, se realizaron unos añadidos del diseño y por ende del consumo al duplicar los componentes del LoRa y ESP32:

Descripción | Consumo mínimo (mA) | Consumo nominal (mA) | Consumo máximo (mA)
ESP32 W-ROOM (x2) | 40 | 240 | 520
SIM800L | 0.7 | 350 | 2000
LoRa SXX 1276 (transmisión) (x2) | 40 | 174 | 240
GPS NEO-6M | 11 | 47 | 67
TOTAL | 91.7 | 811 | 2827

Cuadro 6: Consumos máximos (el SIM 800L esta sujeto a cambios).

Descripción | Consumo (mA)
Transmisión SIM800L | 0.7
Transmisión GPS NEO-6M | 11
Funcionamiento y Recepción LoRa (x2) | 174
Funcionamiento ESP32 W-ROOM con WIFI y BLE activados (x2) | 240
TOTAL | 425.7

Cuadro 7: Consumos promedios estimados.

### 2.5. Otros requerimientos

A continuación se describirán mediante un listado los requisitos para nuestro cargador:

Evitar que la batería se descargue por debajo del 50 porciento mientras se cuente con energía para cargarla.
Deberíamos de tener un detector para corroborar que hay energía solar (usando la información del panel) y crear algún indicativo de cuanta energía hay.

Realizar ciclos de carga completos para baterías AGM, respetando los niveles de voltaje y amperaje en función del ciclo de carga. Se valorará que pueda cargar otro tipo de baterías

Proteger la batería contra sobrecargas evitar que la batería se pueda descargar de noche en el campo fotovoltaico por inversión de corriente

Facilidad de integración en un pcb

Eficiencia para poder aprovechar la mayor energía posible

Temperatura de operación de al menos entre -10°C y 40°C

Posibilidad de ser alimentado con panel solar y otra fuente

Rango de salida de 6V y 2A o superior

Rango de entrada de acuerdo a los valores provistos por el panel solar, (18V) nose como escribirlo, todavía no definí el panel, como voy a decir los valores ¿

No es un requisito indispensable, sin embargo, se valorará que posea alguna interfaz para conocer los datos internos de la batería, como temperatura y nivel de carga. A fin de tener una posible escalabilidad en nuestro proyecto. También se tendrá en cuenta la posibilidad de manejar registros internos del IC para tener un mayor control del mismo.

## 3. Controlador

En la siguiente sección se elegirá el tipo de controlador para el proyecto, siendo estos PWM y MPPT.

### 3.1. PWM

PWM significa modulación de ancho de pulso . Y un controlador de carga solar PWM, aclarado como un interruptor eléctrico entre baterías, se usa para regular la carga de baterías desde paneles solares.
El controlador de carga PMW se puede encender y apagar rápidamente. Posteriormente, se puede obtener el voltaje deseado para cargar las baterías. La corriente de carga disminuirá gradualmente a medida que se carguen las baterías.
Con un controlador de carga PWM, se espera que un cargador basado en luz solar de 12 voltios cargue una batería de 12 voltios, etc. Si utilizó un controlador de carga PWM de una batería de 12 V, pero con cargadores basados en luz solar de 48 V, el PWM ganó no cosechará la energía adicional entregada, solo recolectará 12V.
Comprar un regulador de carga PWM no es realmente una mala decisión a pesar de que es menos eficiente que un MPPT.

### 3.2. MPPT

MPPT, que significa Seguimiento del punto de máxima potencia , es un procedimiento para maximizar la potencia de salida del panel solar mediante el seguimiento y el ajuste continuos del punto de funcionamiento del sistema de energía solar hasta el punto en el que el panel produce la máxima potencia posible. Los cargadores alimentados por luz solar muestran resultados alterables según lo indiquen las condiciones climáticas.
Los controladores de carga MPPT pueden coordinar el voltaje del cargador alimentado por luz solar con el voltaje de la batería para aumentar la capacidad de carga . En estos marcos, se puede utilizar toda la fuerza de los cargadores alimentados por luz solar ajustando el voltaje y la corriente según la condición P = V x A.

Por ejemplo, la cantidad de corriente extraída de los tableros se redujo para garantizar el voltaje cuando el clima está nublado. Cuando el clima es brillante, se permite sacar más corriente. Al usar un controlador de carga solar MPPT, puede usar una pantalla orientada al sol de voltaje que es más alta que el marco de su batería porque su regulador de carga reducirá el voltaje para que no domine su batería.
Suponiendo que necesita una mayor efectividad y está agotado por el estrés del contraste entre la batería y el voltaje del cargador alimentado por energía solar, coloque recursos en un regulador de carga MPPT. Simplemente debe asegurarse de que el VOC de sus placas esté por debajo del voltaje superior de su controlador de carga.

### 3.3. Comparación

| PWM | MPPT
Condiciones de temperatura | Menos 20-25 % de carga | Más adecuado para condiciones más frías
Costo | Más económico | Más caro
Voltaje de ma-triz | Los voltajes de la batería y la matriz fotovoltaica deben coincidir | El voltaje de la matriz fotovoltaica pue-de ser mayor que el voltaje de la batería
Voltaje de la ba-tería | Funciona con el voltaje de la batería, por lo que funciona bien en tempera-turas cálidas y cuando la batería está casi llena | Funciona por encima del voltaje de la batería, por lo que puede proporcio-nar un impulso en temperaturas frías y cuando la batería está baja.
Tamaño del sis-tema | Por lo general, se recomienda su uso en sistemas más pequeños donde los beneficios de MPPT son mínimos | Aproximadamente 150-200 W o más para aprovechar los beneficios de MPPT
Fuera de la red o Grid-Tie | Debe usar módulos fotovoltaicos fuera de la red normalmente con Vmp = 17 a 18 voltios por cada 12 V de voltaje nominal de la batería | Permite el uso de módulos fotovoltai-cos de menor costo/conectados a la red que ayudan a reducir el costo ge-neral del sistema fotovoltaico
Método de dimensiona-miento de matriz | Matriz fotovoltaica dimensionada en amperios (basado en la corriente pro-ducida cuando la matriz fotovoltaica está funcionando con el voltaje de la batería) | Matriz fotovoltaica dimensionada en vatios (basado en la corriente de carga máxima del controlador x voltaje de la batería)
Tipo de Módulo Solar | Sin soporte | Realiza un seguimiento del punto de máxima potencia (por lo tanto, MPPT) de estos módulos de conexión a la red menos costosos para cargar las bate-rías
Eficiencia | | MPPT pueden extraer hasta un 30 % más de energía de un panel solar que los controladores PWM
Flexibilidad | | Más flexibilidad, están diseñados para funcionar con una gama más amplia de voltajes de paneles solares y tam-bién pueden configurarse para funcio-nar con diferentes tipos de baterías
Carga de batería | | Pueden cargar baterías de manera más eficiente y segura
Supervisión | | A menudo vienen con capacidades de monitoreo integradas (rendimiento en tiempo real)
Tipo de Batería | | Algunos están diseñados específica-mente baterías de plomo-ácido o de iones de litio
Sombreado de paneles | | Son mejores para manejar el sombrea-do y el sombreado parcial de los pane-les solares

Cuadro 8: Comparación PWM vs MPPT.

### 3.4. Elección

Tras haber visto una comparación entre los distintos tipos de controladores, se elegirá el controlador MPPT.

## 4. Componentes

A continuación se comenzara a describir los componentes estudiados los cuales podrían servir para la creación de un cargador de batería.

### 4.1. Módulo BMS (HX-2S-01)

Un BMS (Battery Management System) es un sistema que asegura que cada celda de la batería esté operando dentro de su Área de Operación Segura (SOA, por sus siglas en inglés), lo cual incluye:

voltajes máximos y mínimos por celda (absolutamente necesario).

corriente máxima (la mayoría de los BMS hacen esto)

temperatura máxima (varios lo hacen)

temperatura mínima (muy pocos BMS baratos hacen esto, aunque es muy importante para cargas en frío).

En muchos casos, los BMS también balancean la batería y, cuando son digitales, también pueden evaluar el estado de carga (State of Charge, SoC) y brindar información del estado de las celdas.
Dado que el BMS actúa como un interruptor de corriente, cada batería Li-ion necesita uno, imperativamente. Sin excepciones, pues su ausencia puede resultar en fallas catastróficas. Si posee un interruptor, se llama “BMS de protección”; si no lo tiene, se llama “BMS de balance” y envía un mensaje a un sistema externo que actúa como interruptor.
El interruptor en un BMS de protección consiste en dos MOSFETs, uno para controlar la carga y otro para la descarga. El BMS puede, entonces, dejar ambos abiertos si está todo en orden; cerrar el MOSFET de descarga si la batería se vacía, a la vez que permite la carga; cerrar el de carga si la batería está llena, mientras permite la descarga; cerrar ambos, en caso de exceso de corriente o temperatura.
Es estrictamente necesario recalcar que un BMS NO ES UN CARGADOR. Un cargador no protege, y un BMS no limita la corriente de carga, sino que la detiene (tampoco puede disminuirla o modificarla).
Una batería Li-ion requiere ambos dispositivos. A veces se venden dispositivos con ambos, y a veces es necesario comprar dos módulos separados. Para baterías pequeñas (<1kWh), los BMS chinos suelen brindar una protección básica y suficiente. En la práctica, no tiene sentido fabricar un BMS propio, salvo que sea para una aplicación muy específica y que abarque algo que no se encuentra en el mercado.

El módulo provisto se identificó como un BMS HX-2S-01 chino. Está diseñado para actuar como protección de dos celdas 18650 en serie.

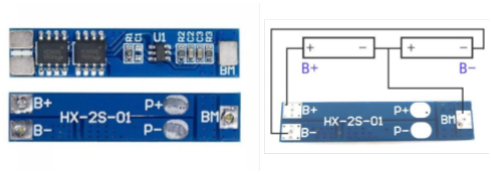
[picture p54: figure]

Figura 2: Módulo BMS (HX-2S-01) - .

Funciona en base al IC HY2120, para monitorear voltajes y corrientes durante las cargas y descargas, y dos MOSFET canal N para cortar cada uno la conexión correspondiente entre la batería, y el cargador o la carga. Funciona como protección, pero al carecer de alguna función de balance, la carga termina cuando la celda con mayor voltaje excede al máximo, y la descarga se corta cuando la celda de menor voltaje cae por debajo del umbral mínimo. Es decir, si las celdas no están balanceadas, entonces nunca se descargarán ni cargarán ambas por completo.
De la hoja de datos (pp. 4), se puede extraer que sus principales características son:

Posee un circuito de detección de voltaje de alta exactitud.

Tiene temporizadores generados por un circuito interno, que no requiere de capacitores externos.

Es de bajo consumo de corriente.

Los pines usados para el conector del cargador soportan hasta 33V como máximo.

Tiene un amplio rango de temperatura operativa (-40°C a +85°C).

Posee un empaquetado pequeño (SOT-23-6).

La serie HY2120 está libre de Halógenos.

La conexión del IC para actuar como protección es la siguiente.

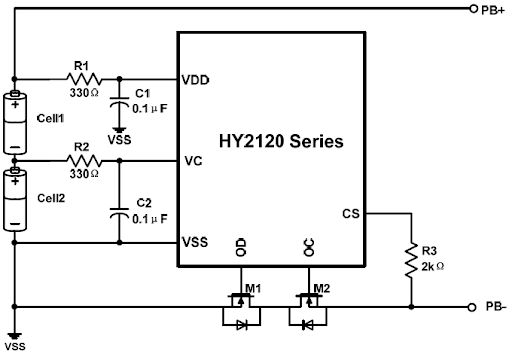
[picture p55: figure]

Figura 3: .

El cargador se conecta en los puertos PB+ y PB-, con un voltaje 8.4 9V. Los mismos puertos se utilizan para descargar mediante una carga.
Durante el funcionamiento normal, el IC monitorea el voltaje de la batería entre los pines VDD y VSS, y la diferencia de voltaje entre CS y VSS. Cuando el voltaje de las celdas 1 y 2 está en el rango entre los voltajes de detección de sobre-descarga (VDLn) y de sobrecarga (VCUn), y el voltaje en el pin CS entre los de sobre-corriente de carga (VCIP) y sobre-corriente de descarga (VDIP), el IC mantiene encendidos ambos MOSFET. Bajo esta condición, tanto la carga como la descarga se pueden llevar a cabo.
Si cualquiera de los voltajes de las celdas 1 (entre VCC y VC) y 2 (entre VC y VSS) es igual o mayor que el voltaje de detección de sobrecarga (VCUn, normalmente 4.2V), y continúa excediéndolo durante el tiempo de retardo de sobrecarga (TOC), el IC coloca el pin OC en un nivel bajo, y el MOSFET correspondiente se abre. La carga se detiene.
Si alguno de los voltajes de las celdas, en cambio, cae por debajo o es igual al voltaje de detección de sobre-descarga (VDLn, 2.9V en general), y se mantiene por un tiempo mayor que el de retardo de sobre-descarga (TOD), el IC pone en bajo el nivel del pin OD y apaga el MOSFET correspondiente. La descarga se detiene.
El pin OD también se pone en nivel bajo si se detecta un valor por encima de los voltajes de detección de sobre-corriente de descarga (VDIP) o de cortocircuito (VSIP) en el pin CS, y estos duran más que los tiempos de retardo de sobre-corriente de descarga (TDIP) o de cortocircuito (TSIP), respectivamente. Esto detiene la descarga de la batería.
De forma análoga, el pin OC también se pone en nivel bajo si el IC detecta un valor menor que el voltaje de detección de sobre-corriente (VCIP) en el pin CS, que se mantenga por un plazo mayor al tiempo de retardo de sobre-corriente de carga (TSIP). El MOSFET correspondiente se abre y se detiene la carga de la batería.
Es recomendable conectar un regulador de corriente a la entrada de los puertos PB+ y PB- para evitar sobre-corriente durante la carga.

Un posible problema surge del hecho que, bajo ciertas condiciones, los MOSFET apagados no retornan a su estado normal salvo con algún tipo de intervención manual. Esto supone un defecto crítico para el uso que se pretende dar al dispositivo, que debe valerse de forma autónoma en la intemperie durante plazos de tiempo largos.

LEER BIEN DS-HY2120-EN.pdf (pp.12) PARA LOS MODOS DE SOBRECARGA, Y EL APARTADO “NOTICE”. Ver bien las condiciones para restablecer los valores de los pines OC y OD. Puede indicar posibles fallos en caso de querer dejar este BMS solo en la intemperie.

### 4.2. Cargador basado en TP4056

Es un cargador de baterías construido en base al IC TP4056, que es similar al CN3065.


Figura 4: TP4056.

Puede funcionar tanto con USB como con adaptadores de pared. No requiere un diodo de bloqueo dada la arquitectura del PMOSFET interno, y tiene protección contra corriente de carga negativa. Una retroalimentación térmica regula la corriente de carga para limitar la temperatura en caso de estar en un ambiente de altas temperaturas o bien bajo un uso de alta potencia.
El voltaje de carga está fijo en 4.2V, y la corriente de carga puede programarse de forma externa mediante un resistor (hasta un máximo de 1000mA). El TP4056 finaliza la carga automáticamente cuando la corriente de carga cae a un décimo de su valor programado, después que el voltaje final haya sido alcanzado.
El TP4056 posee además un monitor de corriente, traba de bajo voltaje, recarga automática y dos pines para indicar la finalización y la presencia de un voltaje de entrada. El voltaje de entrada máximo que soporta es 8V.
Las imágenes siguientes ilustran una aplicación típica y un ciclo de carga.

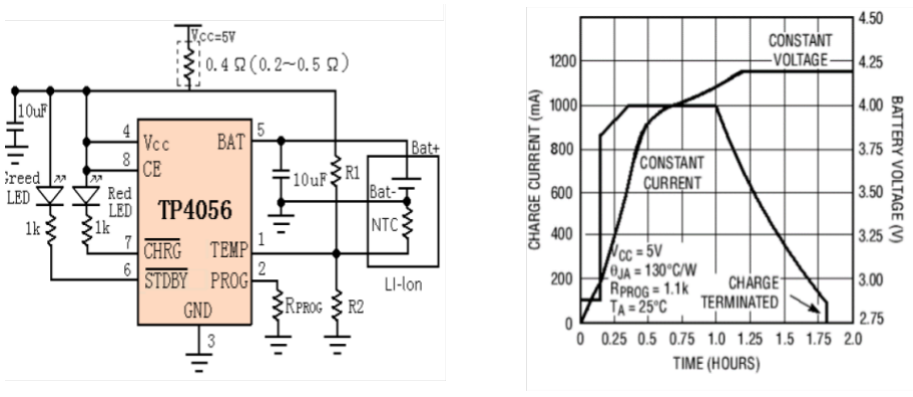
[picture p56: figure]

Figura 5: Aplicación típica y ciclo de carga.

No obstante, a diferencia de otros módulos, su conexión a un panel solar no es directa y requiere de cierto acondicionamiento.

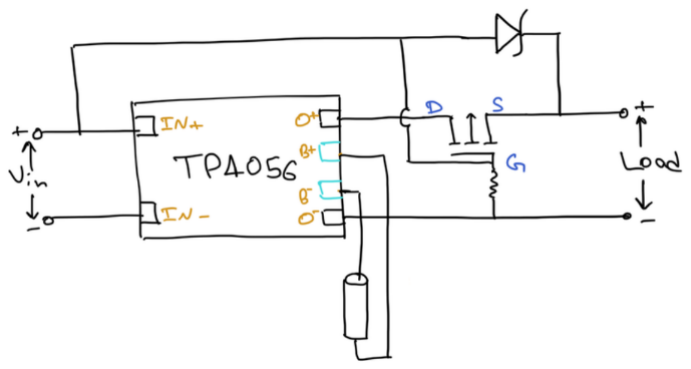
[picture p57: figure]

Figura 6: Acondicionamiento para cargar batería mientras se alimenta la siguiente etapa.

El circuito propuesto se conoce como Load Sharing, y requiere tres componentes básicos: un MOSFET de canal P, un diodo Schottky y un resistor pull-down. Mientras exista una fuente de alimentación, el cargador permanecerá desconectado de la carga, permitiendo que la celda se cargue de forma independiente; en el caso contrario, de no haber fuente, el cargador se conecta y la carga drena las baterías.
Cuando el cargador no está conectado, el pin del gate del MOSFET está en estado bajo, por lo que el transistor se encuentra en estado de conducción y la carga se conecta al TP4056. En el caso contrario, cuando el cargador está encendido, la corriente elige el camino de menor resistencia y por tanto el gate del MOSFET estará en estado alto, lo que conlleva al transistor a no conducir y, por tanto, desacoplar la carga del TP4056.
El diodo está para asegurar que la corriente no fluya desde la batería al cargador cuando el MOSFET está encendido.
Si bien es un módulo económico y esta posible solución permite usarlo con un panel solar, es necesario aclarar que no posee función de MPPT. Sería necesario implementarla mediante otro circuito.
También está el limitante de su corriente de carga máxima de 1A, que no llega al 0.5C de una celda de 7800mAh. Se requeriría posiblemente una modificación del resistor original del módulo, además.
Puede hallarse información más completa acerca del Load Sharing en el documento “Designing A Li-Ion Battery Charger and Load Sharing System With Microchip’s Stand-Alone Li-Ion Battery Charge Management Controller”, de Microchip.

### 4.3. Solar Charger CN3065)

Las baterías de Li-ion requieren de un cargador CCCV (Constant Current Constant Voltage), lo cual significa que, en determinados momentos, el cargador está controlando la salida de corriente a un valor constante, o bien la salida de voltaje.
La carga tiene dos fases, una de corriente constante y otra de voltaje constante. Durante la primera, se regula la corriente a un valor fijo y el voltaje aumenta de a poco a medida que el estado de carga (SoC) aumenta, hasta que se alcanza un determinado voltaje. En ese punto, el cargador empieza a regular el voltaje para mantenerlo en un nivel máximo, mientras que la corriente disminuye en la batería mientras sigue aumentando el SoC.
La corriente constante debe ser configurada de forma de no exceder la corriente máxima de carga de la batería. Si este valor es desconocido y se usa una batería de Li-ion, debe usarse un valor de 0.5C. Por ejemplo, una celda 18650 de 3Ah necesitará una corriente de 1.5A como mucho. Se aconseja no superar el valor de 1C para la carga de baterías de Litio.
El voltaje constante debe ajustarse al mayor voltaje de celda multiplicado por la cantidad de estas en serie. Por ejemplo, para dos celdas de 3.6V (que pueden cargarse hasta 4.2V) en serie, el voltaje constante debe ser de 8.2V.
La mayoría de los cargadores son de tipo bulk. Tienen dos cables (+ y -) para cargar todas las celdas de la batería en serie. Cuando son balanceados, suelen tener varios cables para cargar cada celda de forma individual.
No es recomendable soldar celdas cilíndricas pequeñas. En todo caso, se debe usar el método de welding, con equipamiento especializado. Pero si las baterías no estarán sometidas a vibraciones, un soporte o holder será suficiente.

El cargador provisto fue un Solar Charger V1.0, diseñado por IOTMCU (China) y basado en el IC CN3065.

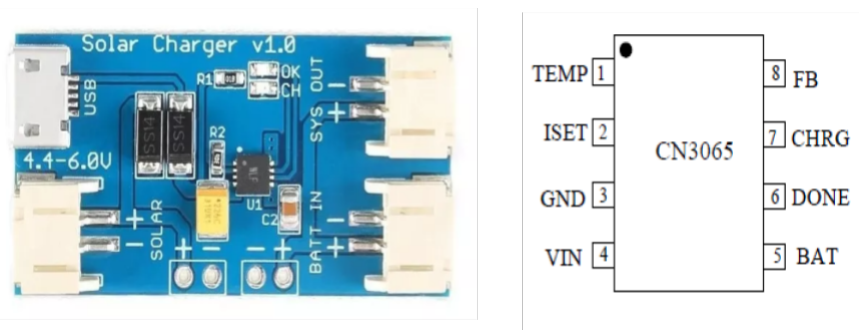
[picture p58: figure]

Figura 7: CN3065.

El CN3065 es un cargador de baterías de litio designado primariamente para cargar celdas individuales de tipo Li-ion o LiPo. Utiliza un MOSFET canal P interno y basa la carga en el método de Corriente Constante Voltaje Constante, o CCCV. La carga de corriente constante puede configurarse hasta 1000mA mediante un resistor externo. No se requiere de ningún diodo de bloqueo. El chip ADC de 8-bit interno puede ajustar la corriente de carga automáticamente basándose en la capacidad de salida de la fuente de poder de entrada, lo que hace al CN3065 ideal para sistemas con paneles solares, o aplicaciones que requieran cargar baterías de Li-ion o LiPo con una fuente de poder de capacidad limitada. Las salidas de drenador abierto y indican el estado del cargador. El circuito interno de regulación térmica reduce la corriente de carga programada si la temperatura intenta elevarse por encima de aproximadamente 115°C, para proteger al integrado.
El ciclo de carga se inicia cuando el voltaje en el pin VIN supera nivel UVLO (Undervoltahe Lockout). El pin se pone en nivel bajo para indicar que la carga se está llevando a cabo. Al inicio del ciclo de carga, si el voltaje en el puerto FB está por debajo de 3V, el cargador se pone en modo precarga para llevar el voltaje de la celda a un nivel seguro para su carga. El cargador entra en modo de carga rápida con corriente constante una vez que el voltaje en FB supera los 3V. En este modo, la corriente de carga está establecida por RISET. Cuando la batería se aproxima al voltaje de regulación, la corriente de carga comienza a disminuir a medida que el CN3065 entra en el modo de voltaje constante. Cuando la corriente cae hasta el umbral de finalización, el ciclo de carga se termina, se pone en bajo y asume un estado de alta impedancia para indicar que el ciclo finalizó. El umbral de finalización de carga es 10 % del valor de la corriente en el modo de corriente constante. Para reiniciar el ciclo de carga, se puede quitar el voltaje de entrada y aplicarlo de nuevo. También puede reiniciarse de forma automática si el voltaje en el pin FB cae por debajo del umbral de recarga. Cuando no hay voltaje presente, el cargador entra en estado sleep, minimizando el drenado de corriente de la batería a menos de 3uA, lo cual incrementa el tiempo de standby.
El perfil de carga es el siguiente:

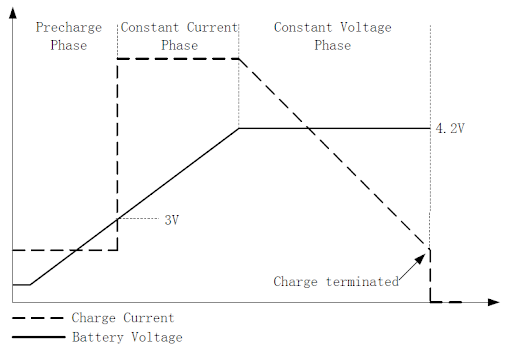
[picture p59: figure]

Figura 8: .

La tabla de características eléctricas del CN3065 indica que soporta voltajes de entrada VIN desde 4.4V hasta 6V como máximo, y corrientes operativas desde 400uA hasta 950uA, con un valor típico de 650uA.
Una característica interesante del CN3065 es que, aunque principalmente pensado para usar con paneles solares, también permite la carga mediante un adaptador de pared o USB. La hoja de datos muestra un ejemplo de cómo implementar el sistema (pp. 9).
Las imágenes siguientes muestran la aplicación típica del CN3065 para una entrada de voltaje variable entre 4.4V y 6V, como podría ser un panel solar; y un esquemático del módulo provisto,

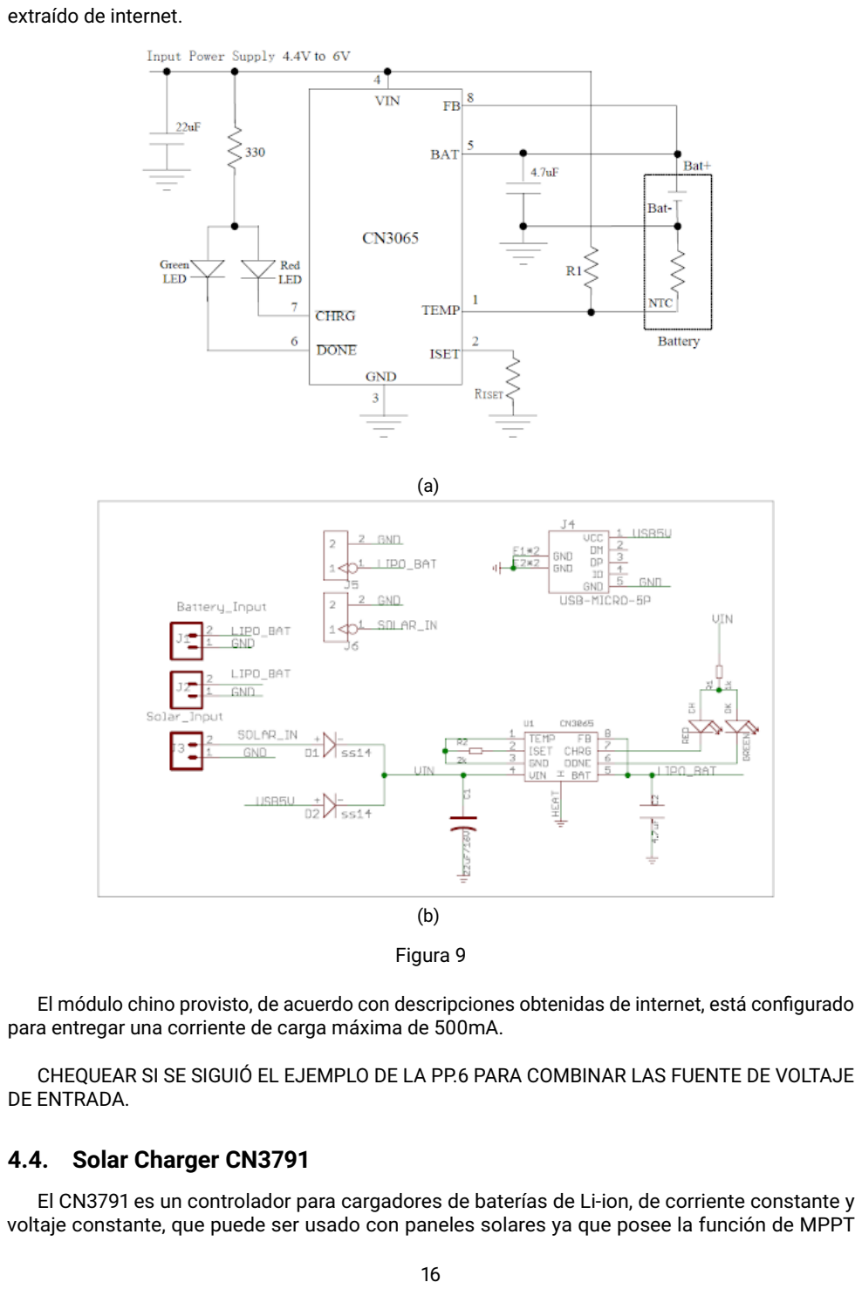
[picture p60: page 17]

extraído de internet.

(a)

(b)

Figura 9

El módulo chino provisto, de acuerdo con descripciones obtenidas de internet, está configurado para entregar una corriente de carga máxima de 500mA.

CHEQUEAR SI SE SIGUIÓ EL EJEMPLO DE LA PP.6 PARA COMBINAR LAS FUENTE DE VOLTAJE DE ENTRADA.

### 4.4. Solar Charger CN3791

El CN3791 es un controlador para cargadores de baterías de Li-ion, de corriente constante y voltaje constante, que puede ser usado con paneles solares ya que posee la función de MPPT

(Maximum Power Point Tracking). La corriente de carga puede configurarse mediante un resistor de censado de corriente externo, RCS, ubicado entre los pines CSP y BAT. El voltaje de regulación final, en el modo de voltaje constante, está programada a 4.2V con una exactitud de ±1 %.

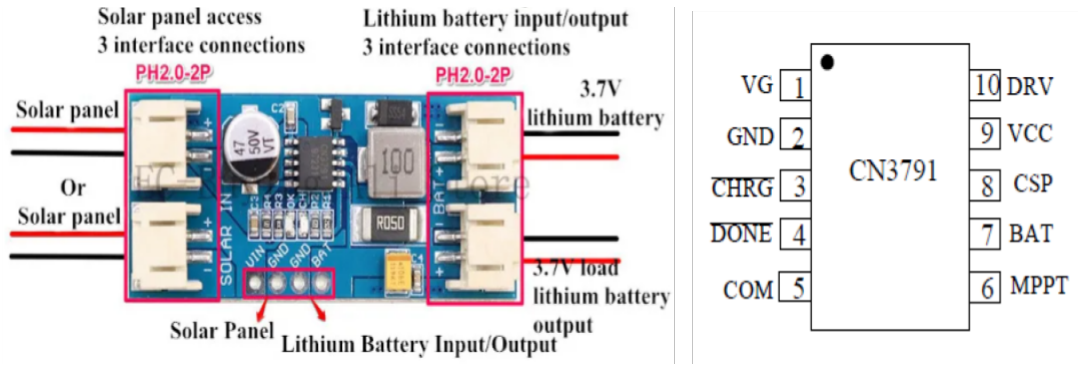
[picture p61: figure]

Figura 10: CN3791.

Un ciclo de carga comienza cuando el voltaje en el pin VCC se eleva por encima de VUVLO y del voltaje de la batería, por VSLPR, y el voltaje en el pin de MPPT es mayor a 1.23V. Si, al comienzo del ciclo, el voltaje de la batería es menor que el 66.5 % del voltaje de regulación (VREG), el cargador entra en modo de carga por goteo; la corriente de carga por goteo está internamente seteada al 17.5 % de la corriente a escala completa. Cuando la batería excede ese 66.5 %, el cargador entra en modo carga de corriente constante, donde la misma está configurada por la resistencia de censado RCS y una referencia interna de 120mV; por lo que la corriente de carga está configurada de acuerdo con la ecuación 120mV/RCS.
Cuando la batería se acerca al voltaje de regulación final, el controlador entra en modo de voltaje constante, y la corriente comienza a decaer hasta alcanzar el 16 % de su valor máximo. En ese punto, la carga se da por finalizada.
El ciclo de carga se reiniciará si el voltaje de la batería cae por debajo del umbral de voltaje de recarga, que es del 95.5 % del valor del voltaje de regulación.
Cuando el voltaje de entrada no está presente, el cargador entra automáticamente en modo de sueño, y todos los circuitos internos se apagan.
El siguiente esquema muestra las etapas del ciclo de carga.


Figura 11: .

Las imágenes siguientes ilustran implementaciones típicas del circuito, que no necesariamente debe coincidir con la de los módulos disponibles en el mercado.

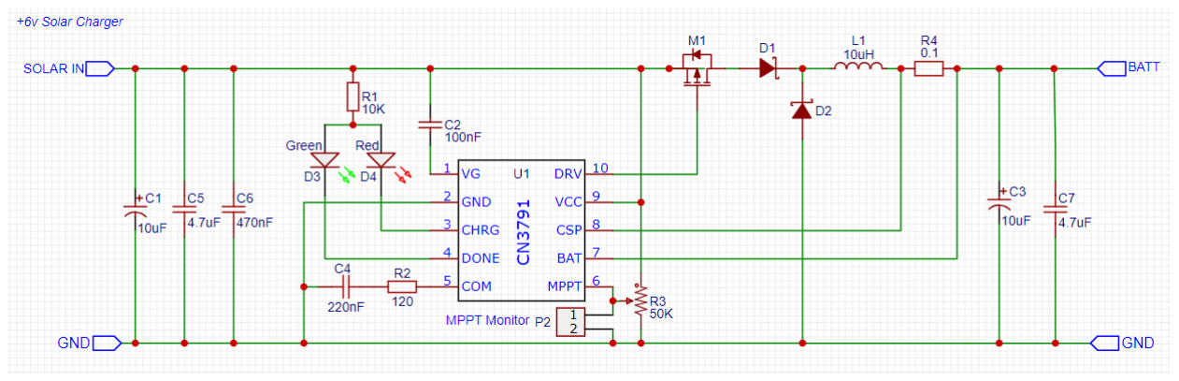
[picture p62: figure]

(a)


(b)

Figura 12

Entre las características del cargador que se encuentran en la hoja de datos, se pueden listar las siguientes:

MPPT.

Gran amplitud de voltaje de entrada: 4.5V a 28V.

Es un controlador completo para cargadores de una sola celda de baterías Li-ion.

Corriente de carga de hasta 4A.

Voltaje constante de 4.2V±1

Configuración de la corriente de carga mediante un resistor de censado de corriente.

Acondicionamiento automático para baterías descargadas.

Recarga automática.

Indicación de estado de carga.

Protección de sobrevoltaje para batería.

Temperatura operativa entre -40°C y +85°C.

Disponibilidad en paquete SSOP de 10 pines.

Libre de plomo y de halógeno.

La característica más llamativa es la capacidad de entregar hasta 4A de corriente de carga, que permitiría cargar una batería de 7800mAh a un ritmo de 0.5C, dadas las condiciones óptimas. Posiblemente requeriría una modificación del PCB a fin de reemplazar la resistencia de censado de corriente por una que permita alcanzar el valor deseado. Lamentablemente, eso quizás conlleve problemas respecto a las pistas de PCB, que quizás no estén listas para tales amperios.
De acuerdo con la ecuación de la hoja de datos, la resistencia debería tener un valor aproximado de:

RCS =

120 mV
3600 mA = 0,033 Ω | (1)

Video demostración YouTube (ruso)¹ (https://www.youtube.com/watch?v=HmbwdlNv5fo&ab_channel=arduinoLab) Video demostración YouTube CN3722² (https://www.youtube.com/watch?v=liYZ5pYOZDE&ab_channel=AdamWelch) Video de la conexión del CN3791³ (https://www.youtube.com/watch?v=fq-0E14beiQ&ab_channel=FreeWeb%26MobileApps)
Video con CN3795 (hace su propio PCB)⁴ (https://www.youtube.com/watch?v=H8DodoxBgBU&ab_channel=MundoElectr%C3%B3nica)

### 4.5. Solar Charger: CN3065 vs CN3791

A continuación se puede observar un cuadro comparativo entre los Solar Charger vistos anteriormente. Se puede observar la superioridad del CN3791 al ver la corriente que suministra, lo cual significa una carga más rápida, pero con un costo más elevado.

| CN3065 | CN3791
Parámetros | Mínimo | Típico | Máximo | Mínimo | Típico | Máximo | Unidad
Voltaje de entrada | 4.4 | | 6 | 4.5 | | 28 | V
Corriente de fun-cionamiento | 0.4 | 0.65 | 0.9 | 0.7 | 1.0 | 1.3 | mA
Corriente de car-ga | | 0.5 | 1 | | 2 | 4 | A
Temperatura ope-racional | -40 | | 85 | -40 | | 85 | °C
Precio | 8.3⁵ (https://articulo.mercadolibre.com.ar/MLA-758232263-cargador-bateria-lipo-uso-panel-solar-cn3065-itytarg-_JM) | 9 (https://articulo.mercadolibre.com.ar/MLA-931093680-mini-placa-de-cargador-solar-lipo-cn3065-_JM) 6 | 16⁷ (https://articulo.mercadolibre.com.ar/MLA-908881593-cargador-bateria-lipo-panel-solar-mppt-cn3065-arduino-_JM) | | 16⁸ (https://articulo.mercadolibre.com.ar/MLA-1106257985-cargador-bateria-lipo-uso-panel-solar-cn3791-arduino-elegir-_JM) | | USD

Cuadro 9: Comparación entre los cargadores solares CN3065 y CN3791.

### 4.6. Voltage Booster

Este componente se encarga de elevar el voltaje de entrada a uno deseado, por lo general se suele regular mediante un trimmer el cual esta incorporado al componente.
Nos sirve como alternativa al no usar 2 celdas en serie para llegar a los 5V.
Se usaría en la etapa final del cargador la cual conecta al dispositivo LoRa.

1https://www.youtube.com/watch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

Nombre | Marca | Precio (USD) | Vin (V) | Iin (A) | Vout (V) | Iout (A) | Eficiencia ( %)
Boost USB cargador⁹ (https://articulo.mercadolibre.com.ar/MLA-672647182-usb-dc-dc-booster-09v-5v-boost-5v-600ma-pcbready-a0068-_JM) | PCBready | 3.8 | 0.9-5 | | 5 | 0.6 | 96
Boost USB cargador (x2)¹⁰ (https://articulo.mercadolibre.com.ar/MLA-1332852466-pack-x2-usb-dc-dc-booster-09v-5v-boost-5v-600ma-pcb-a0068-_JM) | PCBready | 7 | 0.9-5 | | 5 | 0.6 | 96
Mt3608¹¹ (https://articulo.mercadolibre.com.ar/MLA-677992581-convertidor-dc-dc-boost-elevador-tension-step-up-mt3608-_JM) | Duaitek | 2.3 | 2-24 | | 2-28 | 2 | 93
STEPUP-S35B-28V2A¹² (https://articulo.mercadolibre.com.ar/MLA-1408998038-regulador-voltaje-step-up-s35b-dc-dc-booster-2v-hasta-28v-_JM) | TodoMicro | 3.1 | 2-5 | | 2-28 | 2 | 93
Mt3608¹³ (https://articulo.mercadolibre.com.ar/MLA-629847146-convertidor-dc-dc-boost-elevador-tension-step-up-mt3608-2a-_JM) | TecnoliveUSA | 3.3 | 2-24 | | 2-28 | 2 | 93
SX1308 Boost Step-Up¹⁴ (https://articulo.mercadolibre.com.ar/MLA-1160932226-fuente-convertidor-sx1308-boost-elevador-dc-step-up-2a-28v-_JM) | HobbyTronica | 4.3 | 2-24 | | 5-28 | 2 | 95
MT3608 Boost Step-Up¹⁵ (https://articulo.mercadolibre.com.ar/MLA-912188461-fuente-convertidor-mt3608-boost-elevador-dc-step-up-2a-28v-_JM) | HobbyTronica | 4.8 | 2-24 | | 5-28 | 2 | 93
XL6009 Step-Up Booster¹⁶ (https://articulo.mercadolibre.com.ar/MLA-901239868-convertidor-boost-elevador-step-up-dc-dc-5-35v-4amp-xl6009-_JM) | HobbyTronica | 6.3 | 3-32 | 4 | 5-35 | 3 | 94
Step Up LM2587¹⁷ (https://articulo.mercadolibre.com.ar/MLA-1117787623-convertidor-boost-elevador-step-up-dc-dc-4-30v-3a-lm2587-hob-_JM) | HobbyTronica | 16.6 | 3-30 | 5 | 4-30 | 3 | 92

Cuadro 10: Elevadores de Voltaje - Mercado Libre.

Este componente nos servirá debido a que:

Las batería de litio-ion pueden reducir su tensión por debajo de los 3.2V, no pudiendo alimentar la siguiente etapa. Esto nos podría servir para mantener la vida de las baterías durante más tiempo. Esto está en duda, debido a que cuando las baterías estén por debajo de este voltaje, posiblemente ya no les de la corriente necesaria para alimentar la siguiente etapa, que consume en promedio entre 218 y 425mA. Por esto es posible que el step-up no sea necesario.

Antes de la siguiente etapa, existe un regulador de tensión planteado en la tesis .Estación base LoRa para sistemas de alambrado virtual". Este consiste en un step-down que reduce la tensión a 3.2V. Analizándolo nos encontramos con un problema que consiste en que, para reducir la tensión a 3.2V, es necesario un voltaje de entrada mínimo de 4.75V. Esto provoca que la tensión de entrada por debajo a este umbral nunca llegara a 3.2V a la salida del step-down y en consecuencia, no pudiendo abastecer con el voltaje requerido a la siguiente etapa. También se analizaron otros step-down pero todos tienen el mismo problema. Para solucionar este problema, es necesario colocar como mínimo un step-up a la entrada del step-down para aumentar la tensión a 4.75V. También se pensó en aumentar la tensión a 6V, 12V o 18V que son los valores máximos que proveen los paneles solares.

Como se verá más adelante, se propone utilizar un circuito de histeresís (su función y desarrollo se verá más adelante), que para su implementación, es necesario tener alguna tensión constante. Para ello se podría utilizar el step-up configurado para los valores máximos de tensión que proveen los paneles solares normalmente (configurándolo dependiendo de que tipo de tensión máxima tenga el panel que se este utilizando). También como alternativa se podría utilizar la tensión que provee el step-down de 3.3V.

## 5. Circuitos adicionales

En esta sección veremos los circuitos adicionales que pueden ser incorporados al cargador de batería, estos sirven para darle una mejor funcionalidad al cargador.

### 5.1. Load-Sharing (carga compartida)

Este circuito sirve para el intercambio de alimentación entre dos fuentes, siendo que pasa la alimentación que tenga mayor voltaje que la otra. Por ejemplo, la alimentación que esta conectada

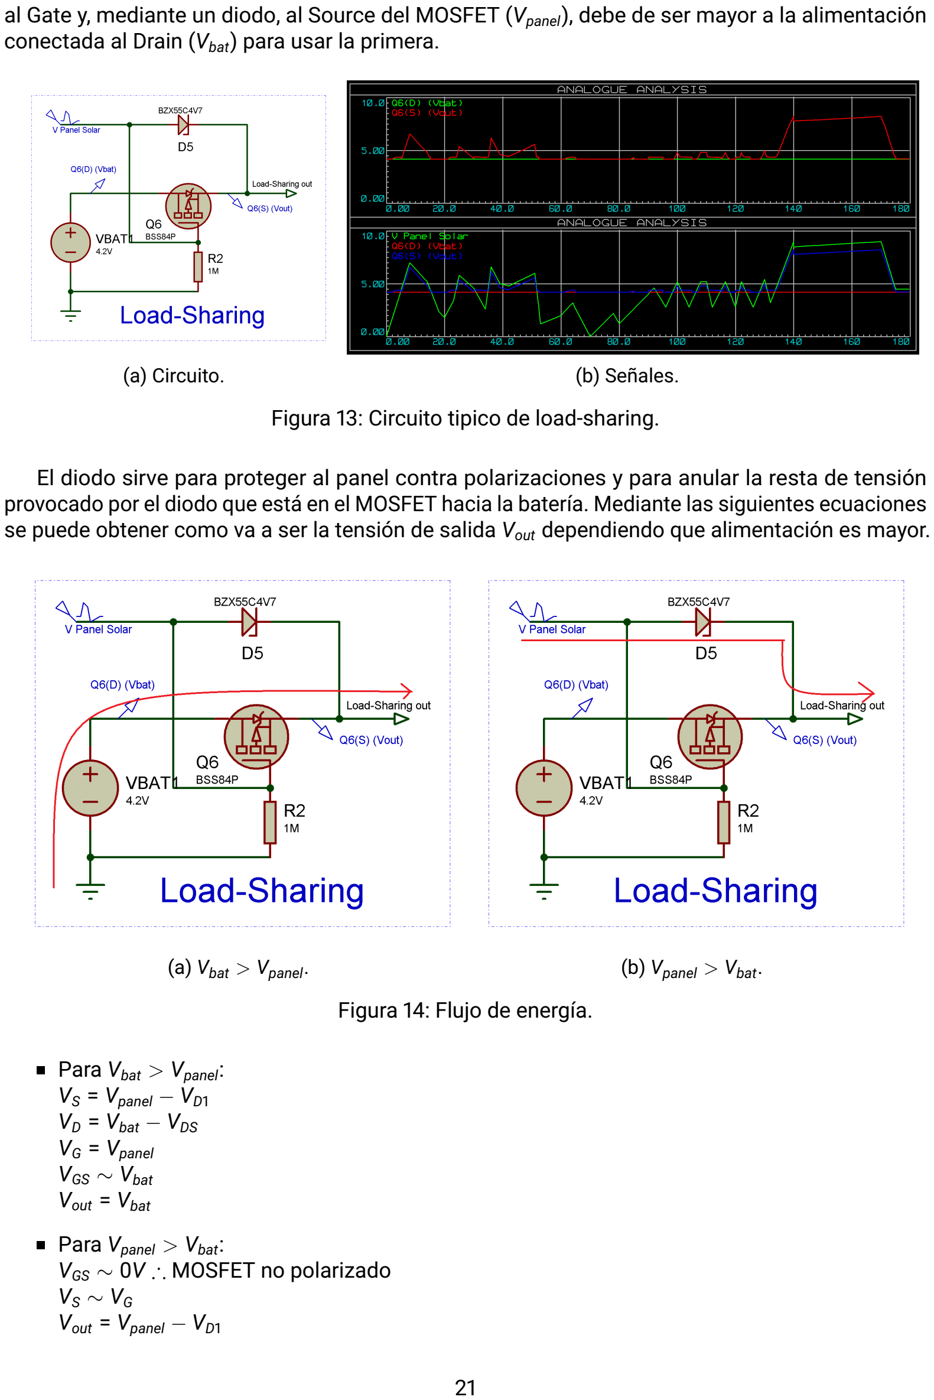
[picture p63: page 22]

al Gate y, mediante un diodo, al Source del MOSFET (Vpanel), debe de ser mayor a la alimentación conectada al Drain (Vbat) para usar la primera.

(a) Circuito. | (b) Señales.

Figura 13: Circuito tipico de load-sharing.

El diodo sirve para proteger al panel contra polarizaciones y para anular la resta de tensión provocado por el diodo que está en el MOSFET hacia la batería. Mediante las siguientes ecuaciones se puede obtener como va a ser la tensión de salida Vout dependiendo que alimentación es mayor.

(a) Vbat > Vpanel. | (b) Vpanel > Vbat.

Figura 14: Flujo de energía.

Para Vbat > Vpanel:

VS = Vpanel − VD1

VD = Vbat − VDS

VG = Vpanel

VGS ∼ Vbat

Vout = Vbat

Para Vpanel > Vbat:
VGS ∼ 0V ∴ MOSFET no polarizado VS ∼ VG

Vout = Vpanel − VD1

Por lo tanto llegamos a que Vs = Vpanel − VD, mientras que Vbat < Vpanel − VD1 + VDS.
Para que la energía pase por el diodo del MOSFET necesitamos que Vbat > VDS + Vpanel − VD1 Por lo que, si Vpanel > VD1

, sino Vbat > VDS
Por último veremos que necesitamos para usar Vbat o Vpanel.

Para usar la batería:

VD > VS

Vbat > VDS | si | Vpanel < VD1
Vbat > VDS + Vpanel − VD1 | si | Vpanel > VD1

Para usar el panel solar:

VG > VS

Vpanel > VD1 | si | Vbat < VDS
Vpanel > VD1 + Vbat − VDS | si | Vbat > VDS

### 5.2. Switching (intercambio de fuentes)

Es un circuito utilizado para el intercambio de alimentaciones, dándole prioridad a la alimentación que estará conectada al Gate (Vwall) por encima a la que estará conectada al Drain (Vpanel).

Cuando no haya energía por Vwall, el MOSFET estará en corte, por lo cual no estará funcionando y pasara la energía de Vpanel por el diodo de arriba.

Cuando haya energía por Vwall, el MOSFET entrara en zona ohmica y estará funcionando y direccionara la energía de Vpanel hacia tierra y la energía de Vwall pasara por el diodo de abajo. Consiste en:

Un MOSFET tipo N.

Dos diodos.

Un capacitor.

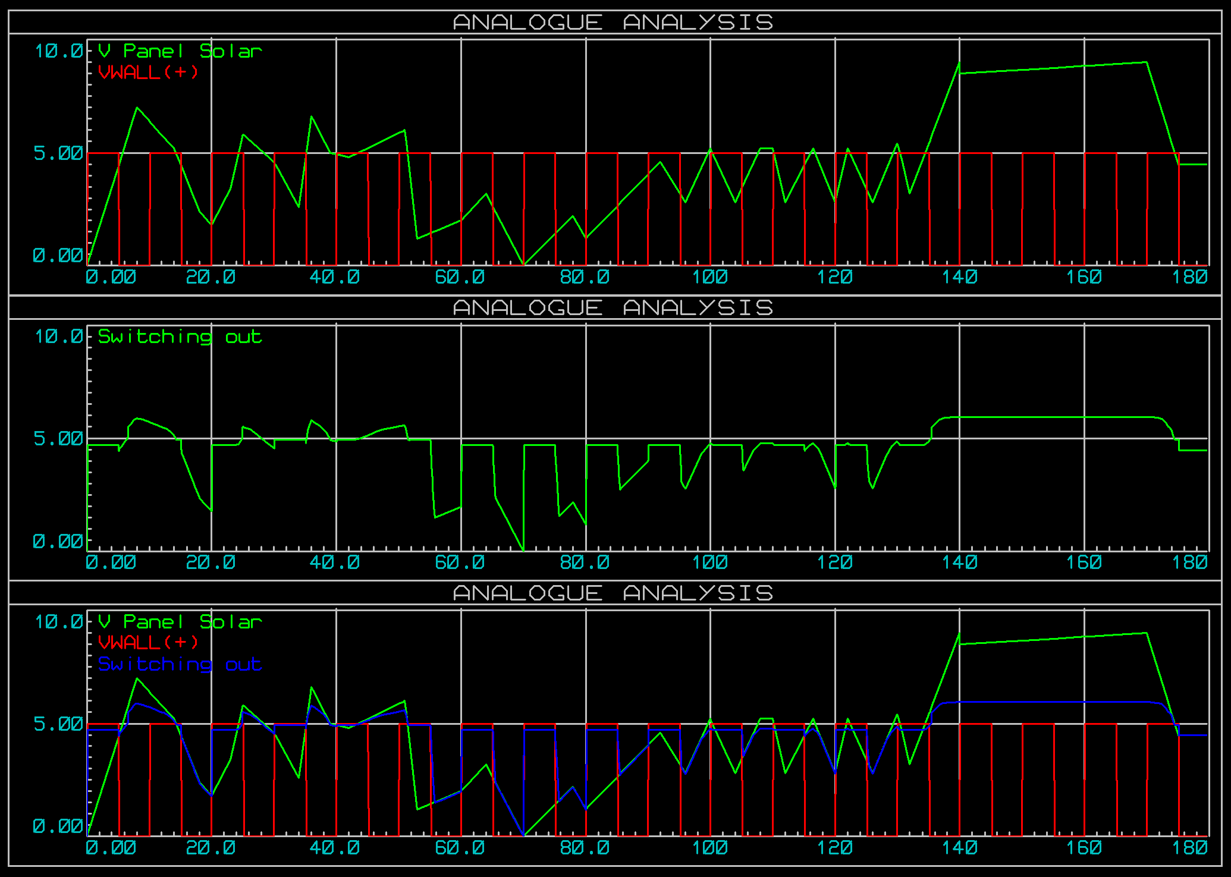
[picture p64: figure]
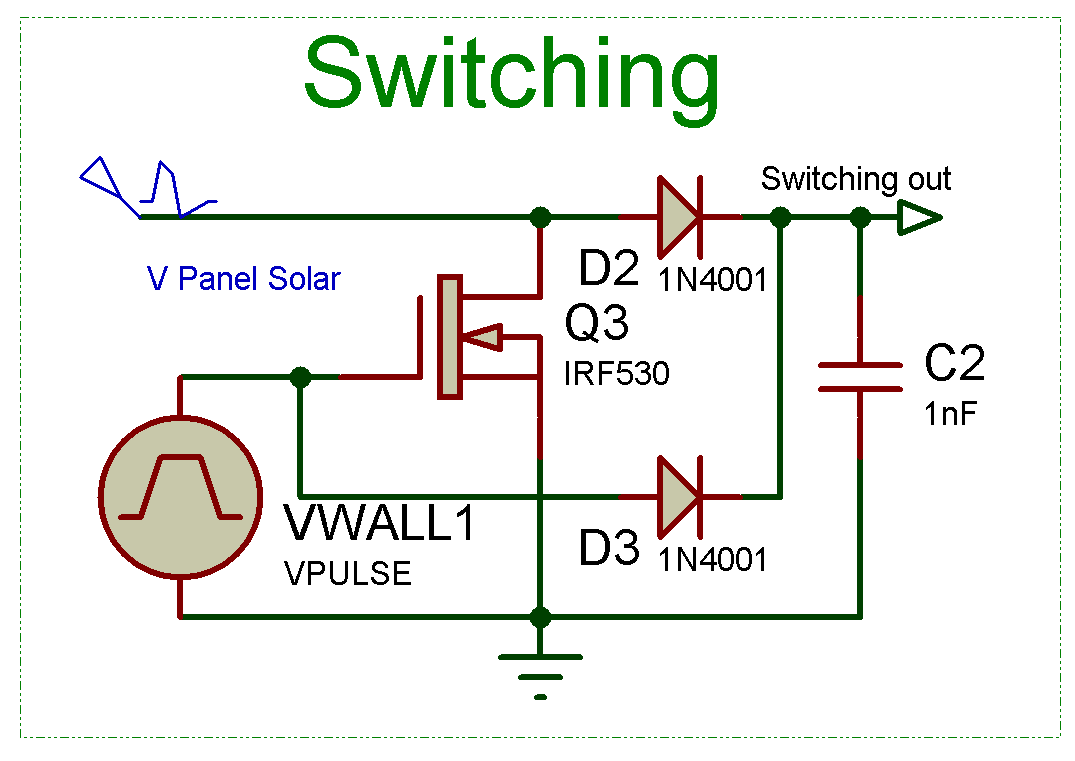
[picture p65: figure]

(a) Circuito. | (b) Señales.

Figura 15: Circuito típico de switching.

### 5.3. Histeresís

Este no consiste en un circuito en si, sino en un concepto que hay que diseñarlo.
Se basa en crear una región la cual el valor de la señal de entrada no tenga efecto en la de salida, mantendiendola en su estado hasta que la señal de entrada salga de esta región por el sitió que genere un cambio en la señal de salida.

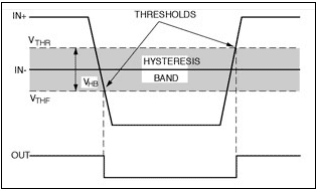
[picture p66: figure]

Figura 16: Barrera digital rodeada por banda de histéresis - IDE Electrónica.

## 6. Diseños final propuesto

A continuación se verán dos diseños propuestos para el cargador de baterías siendo la versión 2.5 y la versión 1.3. Para ver los demás circuitos propuestos se recomienda leer el documento llamado: 2 - Historial de diseños del cargador.

(Aclaración: Varios de los valores de los componentes pueden que no estén en los valores correctos, en especial la resistencias. Debido a las modificaciones que se van produciendo por las limitaciones de software, comportamiento del panel solar y aplicación en físico. Por ello pueden haber diferencias en los valores visto en la practica (Easy-EDA) y los calculados de forma analítica o mediante simulación (Proteus). Cabe destacar que son solo los valores, los componentes y sus respectivas disposiciones están completamente confirmadas).

### 6.1. Versión 2.5

El circuito del cargador consiste en 5 etapas:

Etapa 1 - Switching: Cambia entre la alimentación que provee el panel solar y la que provee una conexión de pared, produciéndose una señal llamada VSwitching. Además, se le conecta un step-down que reducira su voltaje entre 3.3 y 3.8V, produciendo el voltaje llamado VStep−Down.

Etapa 2 - Cargador Solar: Consiste en el cargador solar utilizado y sus respectivas baterías, en nuestro caso, el CN3791 y sus respectivas baterías de litio-ion en paralelo. Produciendo el voltaje llamado VBat. Además que se usara VSwitching para cargar las baterías.

Etapa 3 - Histeresís: Es el encargado de encender o apagar el gate del transistor de la etapa
4. Se crean 2 voltajes umbrales que cambiaran el suministro de energía para la estación base

de entre VStep−Down y VBat.

Etapa 4 - Load-Sharing: Cambia de alimentación que suministra la energía para la estación base de entre VStep−Down y VBat, produciendo un voltaje llamado VLoad−Sharing.

Etapa 5 - Salida (Alimentación): Generara un voltaje fijo proveniente de VLoad−Sharing, el cuál se usara para comparar en la Etapa 3.

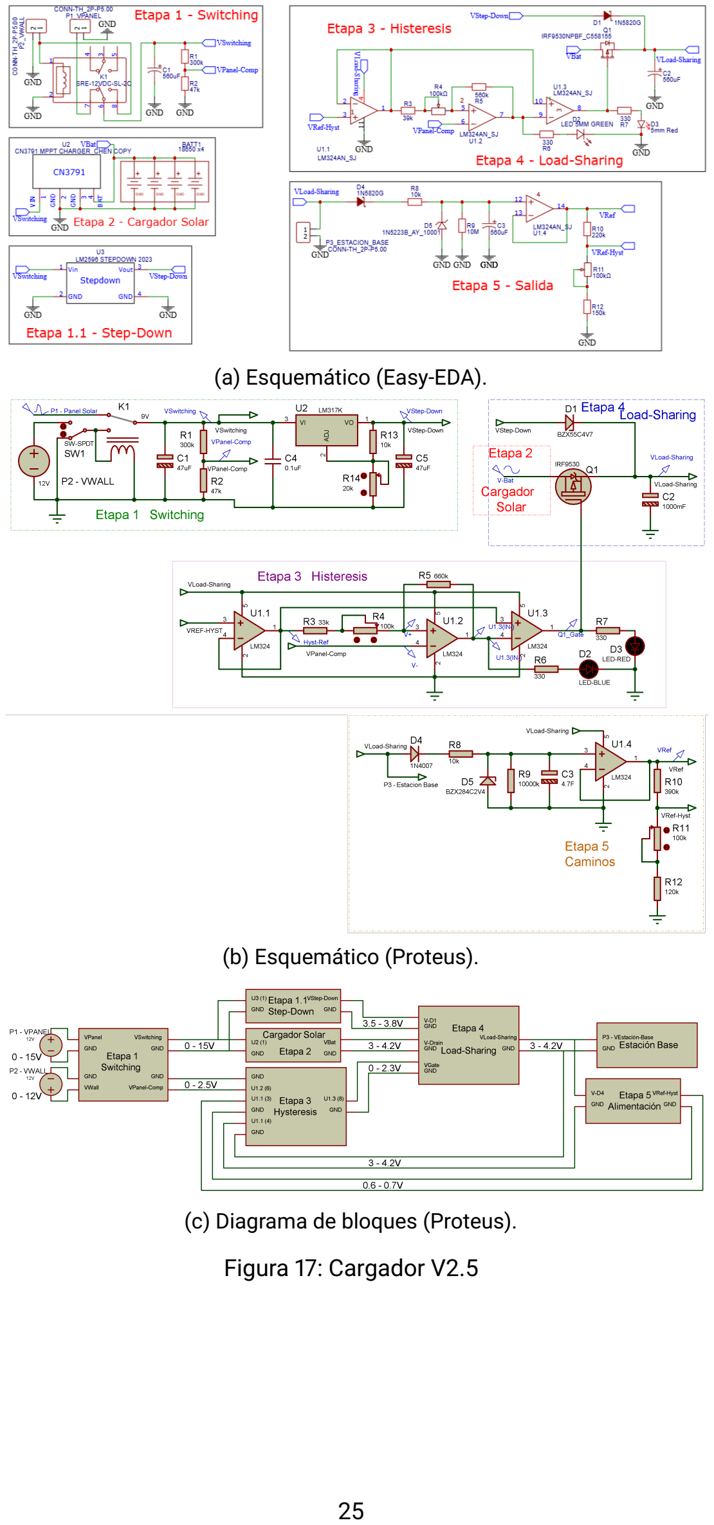
[picture p67: page 26]

(a) Esquemático (Easy-EDA).
(b) Esquemático (Proteus).
(c) Diagrama de bloques (Proteus).

Figura 17: Cargador V2.5

### 6.1.1. Etapa 1 - Switching

Esta es la etapa de entrada del cargador, la cual alimentara al cargador solar (CN3791) y al step-down de la etapa 3. Funciona con dos entradas, siendo la del panel solar (P1), llamada desde ahora VPanel y un voltaje provisto desde la pared (P2), llamada desde ahora VWall. Como dice su nombre, consiste en cambiar la fuente de alimentación entre las antes mencionadas, teniendo esta última la prioridad. Cuando se conecte VWall, cambiará la entrada del relé K1

, sustituyendo a
VPanel. También se coloca un capacitor (C1), el cuál nos servirá para sostener el voltaje cuando se produzcan los cambios de alimentación.
Además contiene un divisor de voltaje, llamado VPanel−Comp, el cuál tiene la función de reducir de 18V a 2.5V. Esto debido a que este voltaje se usara como comparación en otras etapas, la cual debe reducir el valor máximo del switching, llamado desde ahora VSwitching (siendo este el voltaje máximo del panel solar) a ese valor como tope. Siendo así, ya que los OpAmps que usaremos para comparar, serán alimentados desde la salida del cargador, la cuál variara entre 3 y 4.2V. Se utiliza 2.5V y no otro voltaje, debido a que nuestros OpAmps comienza a comparar a partir de 500mV por debajo del voltaje de alimentación de estos, por lo que tomando el valor mínimo de 3V sería 2.5V. VSwitching estará conectado a un step-down (LM2596) el cuál reducirá el voltaje entre 3.3 y 3.8V, produciendo el voltaje VLoad−Sharing.

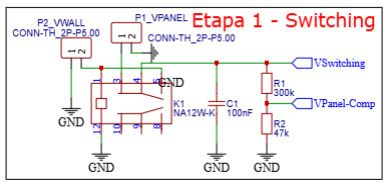
[picture p68: figure]

(a) Esquemático (Easy-EDA).

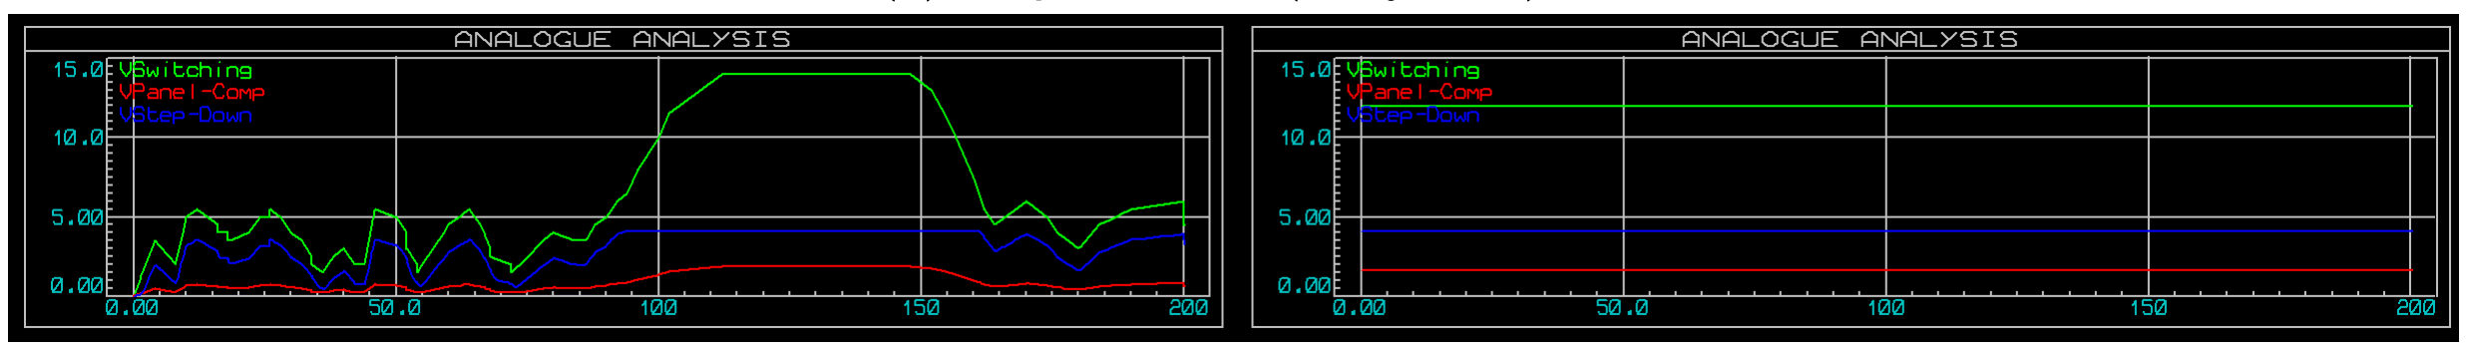
[picture p69: figure]

(b) Gráficos (Proteus).Izquierda: VPanel. Derecha: VWall.

Figura 18: Etapa 1.

### 6.1.2. Etapa 2 - Cargador Solar

Esta etapa solo consiste en el CN3791 o algún otro cargador solar que usemos junto a la batería, siendo en nuestro caso las baterías de litio-ión.
Se alimentara mediante VSwitching y su salida estará conectada al drain del MOSFET de la etapa de Load-Sharing.
Su propósito es de cargar las baterías y el de alimentar a la estación base mientras la energía de VSwitching no sea capaz de alimentar a esta. La alimentación sera proporcionada por las baterías, las cuales llamaremos VBat.

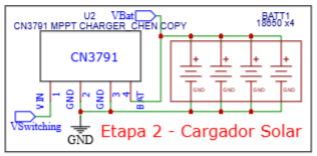
[picture p70: figure]

Figura 19: Etapa 2.

### 6.1.3. Etapa 3 - Histeresís

Esta etapa consiste en elegir dos voltajes umbrales que nos servirán para activar o no, el gate del MOSFET de la etapa de Load-Sharing. Cuya función del gate es la de dejar pasar a VSwitching sobre VBat.
Su implementación nos evitara cambios constantes entre VSwitching y VBat debido a las oscilaciones del primero. Esta etapa es realmente beneficiosa para paneles de 6V, en nuestro caso, nos servirá para el amanecer y anochecer, además de seleccionar a conveniencia en que voltaje se cambiara de alimentación.
El primer OpAmp (U1,1) está en configuración de buffer, siendo así, para separar la tensión que usaremos como uno de los voltajes de referencia. Este voltaje de referencia será el inferior, el cual llamaremos VRef− cuyo valor será de aproximadamente de 4V. La idea es que cuando VSwitching sea menor a este valor, el gate se apague y deje pasar el voltaje de VBat. Este voltaje proviene de un divisor de tensión que reduce el voltaje de un step-down, llamado VRef, de 1.2V a 0.416V, esto debido a que nuestro nuevo voltaje tope es 2.5V.
El segundo OpAmp (U1,2) es el que está en configuración de disparador Schmitt. Esta configuración es como un comparador normal, con la señal que se quiere comparar, siendo VPanel−Comp por la pata V−. Pero lo que cambia es que hay una realimentación en la pata V+, que esta conectada a la salida del buffer antes mencionado. Esta realimentación está dada por un divisor de tensión el cual sumara o restara un voltaje al suministrado por el buffer. El cuál será suma o resta si el comparador tiene como salida un 1 lógico, siendo la suma, o un 0 lógico, siendo la resta.
Como el OpAmp esta alimentado a tierra, no se le restara nada, quedando como resultado el voltaje del buffer cuando a la salida del OpAmp hay un 0 lógico. En caso de un 1 lógico como salida del OpAmp, se le sumaran 0.27V, esto siendo así para llegar a 0.694V y establecer aproximadamente 5V como umbral alto (VRef+). Por lo cual, se activara el gate y por lo tanto, se cambiara la alimentación de VBat a VSwitching a partir de los 5V.

VBuffer =

VRefR1
R1 + R2

∼ 0,416V

VRef− = VBuffer +

VOpAmp−AltoR2
R1 + R2

= 0,416V + 0,27V ∼ 0,694V

VRef+ = VBuffer −

VOpAmp−BajoR2
R1 + R2

= 0,416V + 0 = 0,416V

Queda mencionar que la salida del OpAmp queda de forma inversa para el funcionamiento del gate del Load-Sharing. Por eso, se agrega un tercer OpAmp (U1,3) en configuración de comparador, el cual comparará la salida del OpAmp U1,2 con un voltaje fijo que tenga un valor mayor a 0 pero menor al voltaje del OpAmp U1,2 cuando tenga una salida lógica alta. Por lo cual, cuando el OpAmp U1,2 tenga una salida baja, este tendrá una alta y si tiene una alta, este será una baja y así invirtiendo la salida. La salida de este comparador irá al gate del transistor del load-sharing.
Además, irán dos didios que funcionarán como indicadores. El diodo D2 estará conectado a la salida del OpAmp U1,2, al encenderse indicará que la estación base esta siendo alimentada mediante VBat. Para el diodo D3, estará conectado a la salida del OpAmp U1,3, al encenderse nos indicara que la estación base esta siendo alimentada mediante VSwitching.

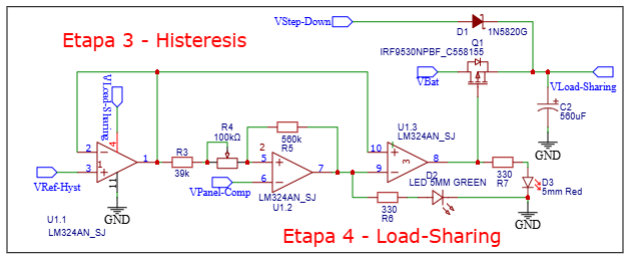
[picture p71: figure]

(a) Esquemático (Easy-EDA).

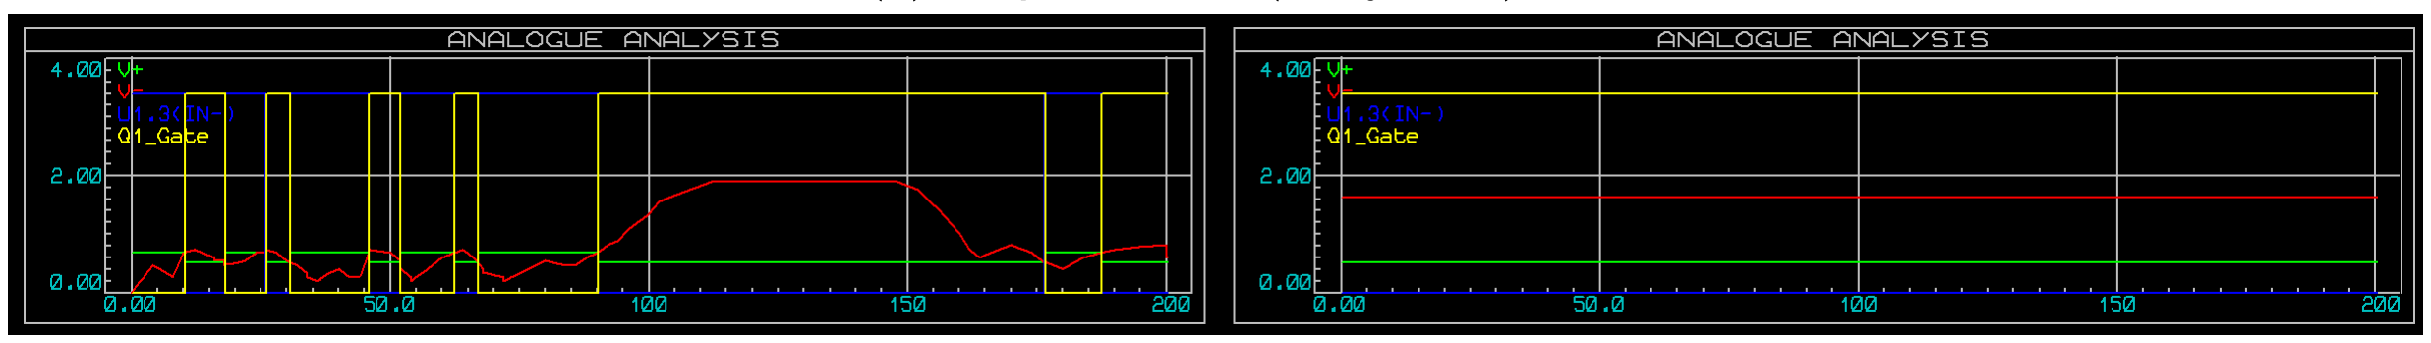
[picture p72: figure]

(b) Gráficos (Proteus).Izquierda: VPanel. Derecha: VWall.

Figura 20: Etapa 3.

### 6.1.4. Etapa 4 - Load-Sharing

Este circuito nos servirá para cambiar la alimentación de la estación base entre VBat y VStep−Down. Su cambio de alimentación estará establecido por la Etapa 3. La salida de esta etapa estará conectada a la etapa de Caminos.
Sin la Etapa 3, el load-sharing cambia la alimentación cuando el voltaje de VStep−Down es mayor al voltaje de VBat.
Además, esta etapa contiene un capacitor (C2), el cuál nos servirá para sostener el voltaje cuando se produzcan los cambios de alimentación.
A continuación se mostrará las condiciones para que la estación base sea alimentado ya sea por

VStep−Down o VBat:

Para VStep−Down: VStep−Down > VBat y Vgate −→ ON.

Para Vbat : caso contrario.

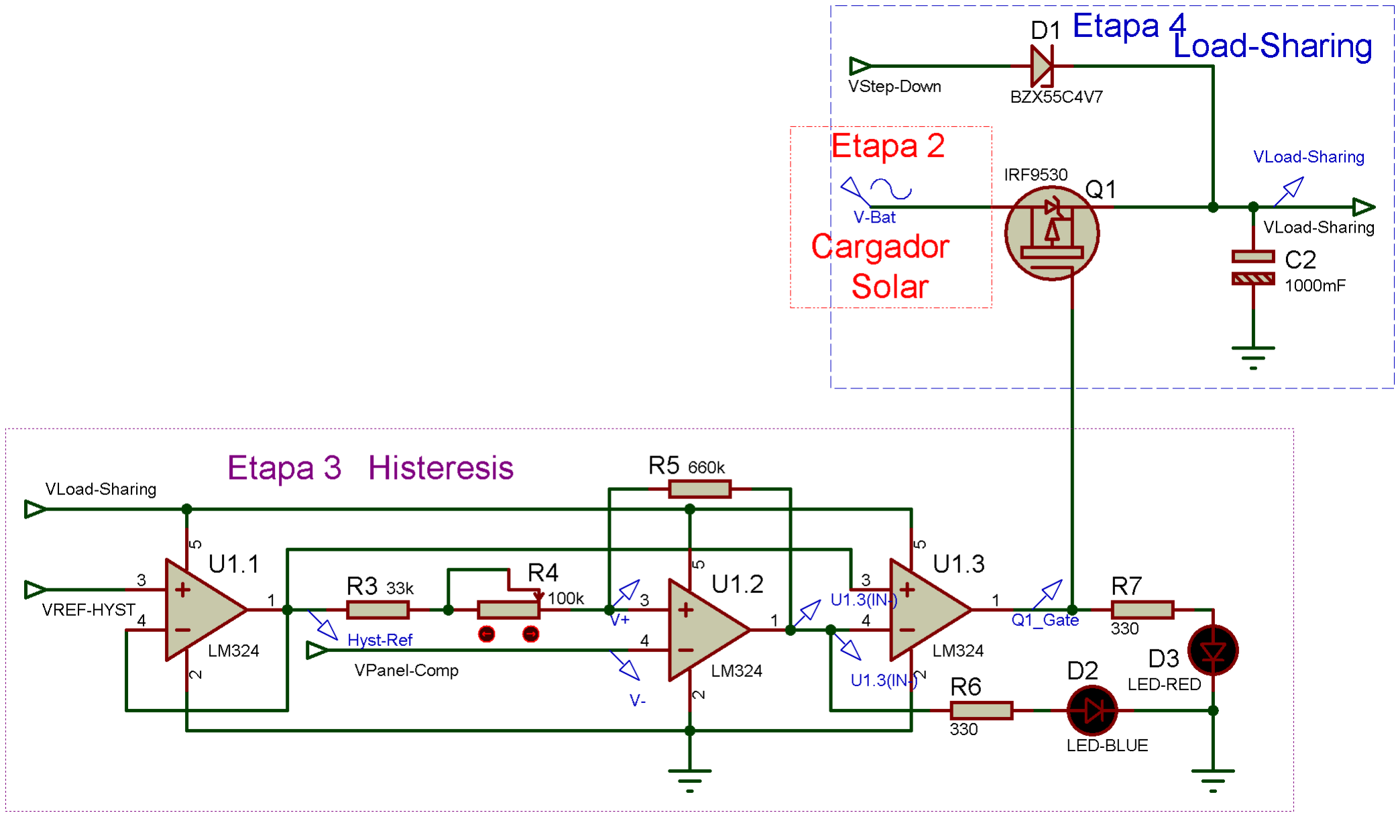
[picture p73: figure]

(a) Esquemático (Proteus).

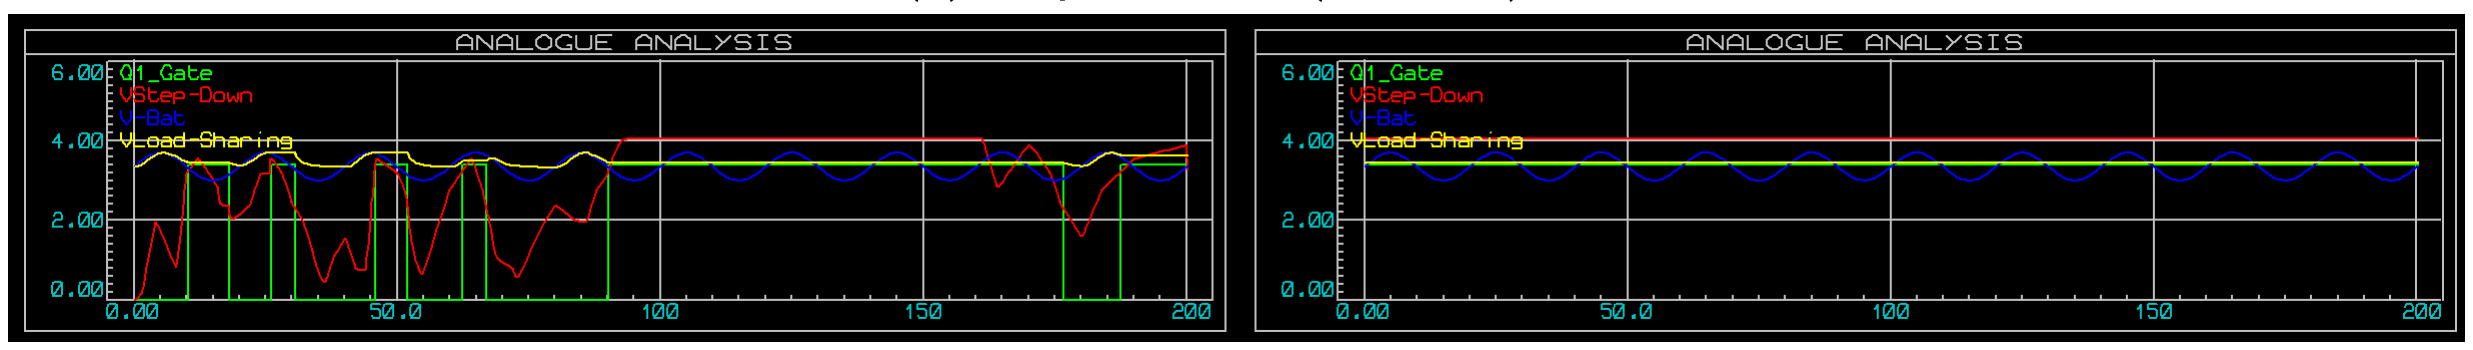
[picture p74: figure]

(b) Gráficos (Proteus).Izquierda: VPanel. Derecha: VWall.

Figura 21: Etapa 4.

### 6.1.5. Etapa 5 - Salida (Alimentación)

Esta es la ultima etapa, además de alimentar a la estación base (P3), alimentará un step-down que reduce a 1.2V el voltaje proveniente del load-sharing, cuyo voltaje resultante es llamado VRef. Este step-down funciona con un diodo de 2.7V (D5) y dos resistencias R7 y R8, además se le agrega un capacitor (C3) para mantener el voltaje ya que oscila entre 1.28 y 1.32V. Este cambió de voltaje parece poco pero resulta significativo para el divisor de tensión que le sigue, el cuál nos servirá para comparar en la etapa 3, llamado VVRef−Histeresis.
Se agrego un trimmer de 100kΩ para variar este divisor de tensión, ya que en la realidad, queda ver cual es el voltaje de referencia ideal para el panel solar que usemos.

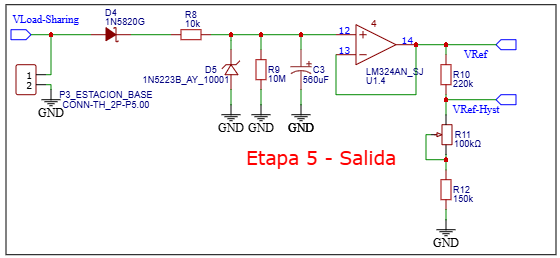
[picture p75: figure]

(a) Esquemático (Easy-EDA).

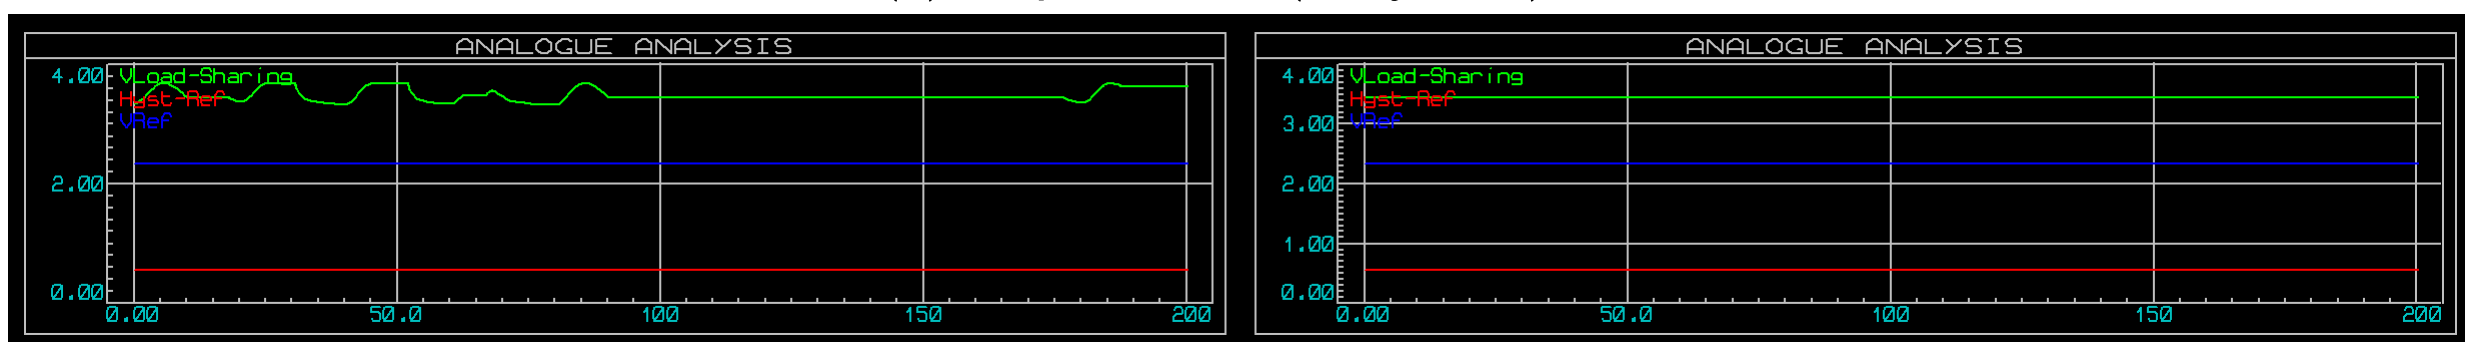
[picture p76: figure]

(b) Gráficos (Proteus).Izquierda: VPanel. Derecha: VWall.

Figura 22: Etapa 5.

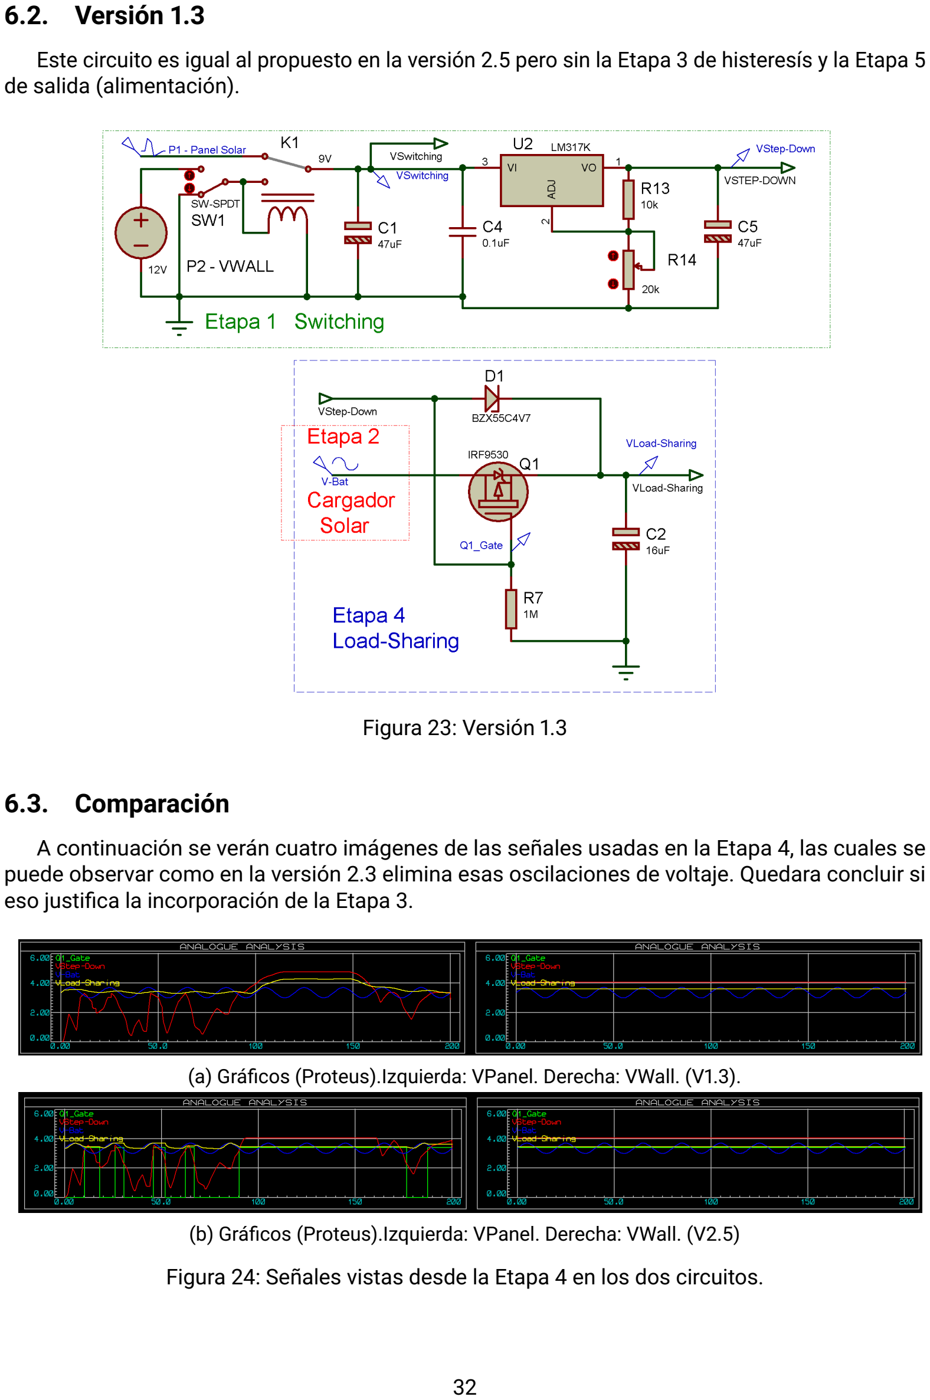
[picture p77: page 33]

### 6.2. Versión 1.3

Este circuito es igual al propuesto en la versión 2.5 pero sin la Etapa 3 de histeresís y la Etapa 5 de salida (alimentación).

Figura 23: Versión 1.3

### 6.3. Comparación

A continuación se verán cuatro imágenes de las señales usadas en la Etapa 4, las cuales se puede observar como en la versión 2.3 elimina esas oscilaciones de voltaje. Quedara concluir si eso justifica la incorporación de la Etapa 3.

(a) Gráficos (Proteus).Izquierda: VPanel. Derecha: VWall. (V1.3).
(b) Gráficos (Proteus).Izquierda: VPanel. Derecha: VWall. (V2.5)

Figura 24: Señales vistas desde la Etapa 4 en los dos circuitos.

### 6.4. Fabricación del cargador

Se diseño el PCB del cargador en Easy-EDA.

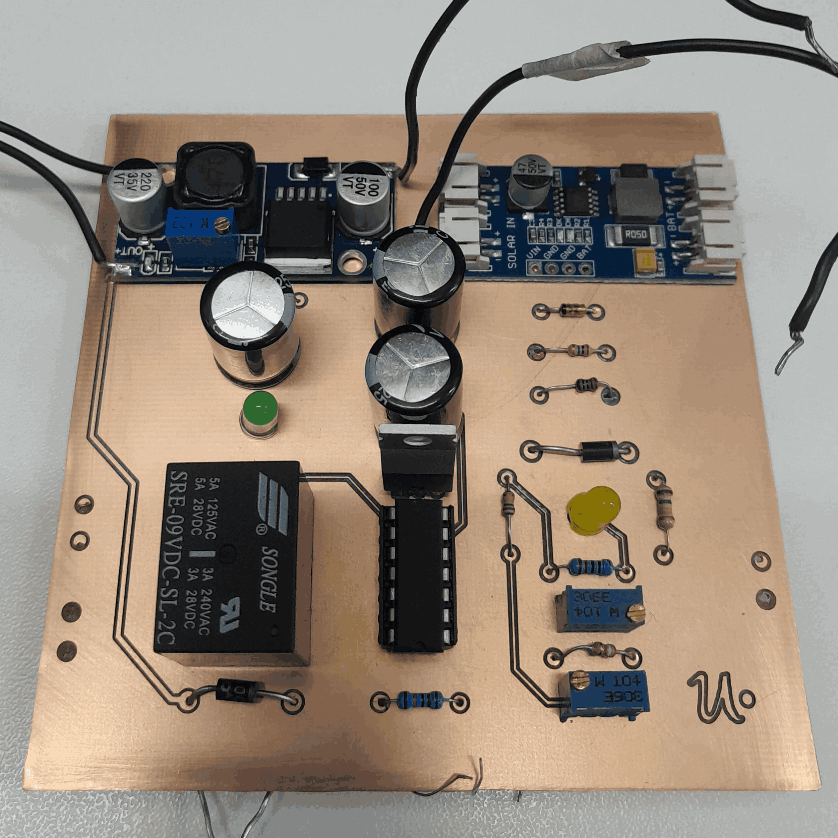
[picture p78: figure]
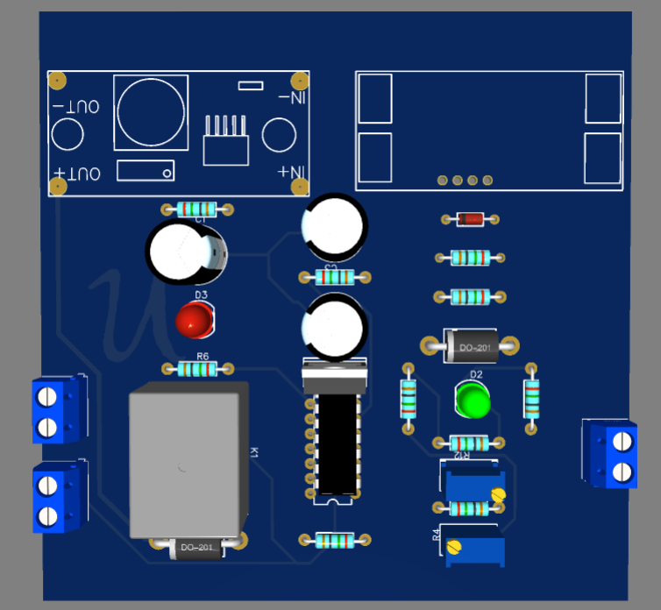
[picture p79: figure]

(a) PCB diseñado. | (b) PCB fabricado.

Figura 25: Cargador Solar V2.5

## 7. Elección de componentes

Componente | Requisitos | Utilizado
Etapa 1 - Switching
Conector P1 (VPanel) | 15V y 5A | Bornera.
Conector P2 (VWall) | 15V y 5A | Bornera.
Relé K1 | 15V y 5A | SRE-12VDC-SL-2C
Capacitor C1 | Electrolito y de alta capacitancia | Electrolito 560µF
Resistencia R1 | 1µW y 300kΩ | 1/4 Watt y 300kΩ
Resistencia R2 | 1µW y 47kΩ | 1/4 Watt y 47kΩ
Step-Down U3 | Reducir de 15V a 3V | LM2596
Etapa 2 - Cargador Solar
Cargador Solar U2 | 12V y 5A | CN3791 versión de 12V
Portapilas Batt1 | Colocar varías baterías en paralelo 18650 (no asigana-do) | No asignado

Etapa 3 - Histeresís
OpAmps U1 | 4 OpAmps, alimentación negativa con GND, alimenta-ción positiva mínima de 3V y máxima de 5V | LM324
Resistencia R3 | 1µW y 39kΩ | 1/4 Watt y 39kΩ
Trimmer R4 | 100kΩ o 200kΩ | W104 306E 2396 (100kΩ)
Resistencia R5 | 1µW y 560kΩ | 1/4 Watt y 560kΩ
Resistencia R6 | 1µW y 220Ω | 1/4 Watt y 220Ω
LED D2 | LED 5mm Verde | LED 5mm Verde
Resistencia R7 | 1µW y 220Ω | 1/4 Watt y 220Ω
LED D3 | LED 5mm Amarillo | LED 5mm Amarillo
Etapa 4 - Load-Sharing
Diodo D1 | Diodo de baja caída de voltaje | 1N5820 o 1N4007 (peor caso)
Transistor Q1 | Transistor MOSFET canal P con capacidad conmuta-ción y amplificación | IRF9530
Capacitor C2 | Electrolito y de alta capacitancia | Electrolito 560µF
Etapa 5 - Salida
Diodo D4 | Diodo de baja caída de voltaje | 1N5820 o 1N4007 (peor caso)
Resistencia R8 | 1µW y 10kΩ | 1/4 Watt y 10kΩ
Diodo D5 | Diodo Zener de 2.7V | 1N5223B
Resistencia R9 | 1µW y 10MΩ | 1/4 Watt y 10MΩ
Capacitor C3 | Electrolito y de alta capacitancia | Electrolito 560µF
Resistencia R10 | 1µW y 220kΩ | 1/4 Watt y 220kΩ
Trimmer R11 | 100kΩ o 200kΩ | W104 306E 2396 (100kΩ)
Resistencia R12 | 1µW y 150kΩ | 1/4 Watt y 150kΩ

Cuadro 11: Tabla de elección de componentes.

## 8. Fallas

En la siguiente sección se verá que sucede en caso de falla de los componentes del cargador de baterías, el cuál se realizara etapa por etapa.

### 8.1. Etapa 1 - Switching

Esta etapa es fundamental, debido a que es la que se encarga de suministrarle energía a la etapa 2 para cargar la batería, además de generar una vía alternativa para alimentar a la estación base. A continuación se verá que sucederá si fallan sus componentes. En caso de romperse el capacitor C1 o la resistencia R2, producirá un mal comportamiento del circuito, ya sea porque, va a haber un bajón abrupto de tensión al activarse VWall o una mala comparación en la etapa 3 además de una sobre tensión en la entrada de su OpAmp respectivamente.
En caso de fallar el conector de VWall o el relé K1 en las patas 1, 4, 5 o 12, producirá que la estación base y la carga de las baterías no pueda ser suministrada mediante la alimentación de pared. En caso de fallar el conector de VPanel o el relé K1 en las patas 3 o 4, producirá que la estación base y la carga de las baterías no pueda ser suministrada mediante la alimentación producida por el panel solar.
Cabe destacar que en caso de fallar la pata 4 del relé K1
, solo se podrá alimentar mediante VBat hasta que se le acabé la batería debido que tampoco podrán ser cargadas.
En caso de fallar R1
, producirá que el voltaje del panel no pueda ser comparada en la etapa 3, por lo cuál producirá que el load-sharing de la etapa 4 deje pasar solo la alimentación proveniente de VBat.

### 8.2. Etapa 2 - Cargador Solar

En caso de fallar esta etapa, la estación base se suministrará solamente mediante VSwitching. En esta situación, la estación base solo podrá sobrevivir de forma constante si esta funcionando VWall. En caso contrario, o sea que este alimentado solo por VPanel, la estación base solo funcionara cuando este pueda suministrarle la energía necesaria para su funcionamiento. Por lo cual, mientras no haya luz solar, la estación base permanecerá apagada.
Las fallas en las celdas provocará que vaya disminuyendo la capacidad, y con ello, la autonomía del cargador.

### 8.3. Etapa 3 - Histeresís

Esta etapa, al ser el controlador del gate del transistor de la etapa 4, puede producir diferentes situaciones al fallar alguno de sus componentes. Los cuales se verán a continuación.
Al romperse cualquier pata de U1,1 o U1,3 o la pata 6 de U1,2, provocará que el gate se mantenga apagado constantemente. Y con ello, transistor de la etapa 4 solo dejara pasar la energía proveniente de VBat.
En caso de fallar R3, R4, la pata 5 o 7 de U1,2 o la pata 9 de U1,3, provocará que el gate siempre este activo. Por lo cual, el load-sharing funcionara como uno normal, provocando que se cambie a la alimentación a VStep−Down cuando el voltaje de este sea superior al de VBat. Esto puede suponer un grave problema, debido a que no esta garantizado que a ese voltaje, el panel solar generé la corriente suficiente para mantener viva a la estación base.
Si falla R5, producirá que la Histeresís no funcione perdiendo su función de realimentación. Por lo cual, el U1,2 funcionará como un comparador normal de un solo voltaje de referencia.
Al fallar el diodo D2 o la resistencia R6 simplemente se pierde el indicativo de cuando se suministra la energía a la estación base mediante VBat. Lo mismo pasa cuando se le suministra energía mediante VStep−Down, pero con el diodo D3 y la resistencia R7.

### 8.4. Etapa 4 - Load-Sharing

En caso de romperse el gate de Q1

, provocará que este solo deje pasar la energía proveniente de VBat.
Si fallara el drain, la estación base solo puede sobrevivir de forma constante si esta funcionando VWall. En caso contrario, o sea que este alimentado solo por VPanel, la estación base solo funcionara cuando este pueda suministrarle la energía necesaria para su funcionamiento. Por lo cual, mientras no haya luz solar, la estación base permanecerá apagada.
Al fallar D1
, provocará que la estación base sea alimentado solo por VBat. La estación base dejaría de ser suministrada en caso de falla en el source de Q1
. Este componente
es fundamental para el funcionamiento del circuito y una falla en esta parte puede provocar el no suministro hacia la estación base.
En caso de fallar C2, provocará que haya un cambió abrupto de voltaje durante el cambió de alimentación.

### 8.5. Etapa 5 - Salida

Al fallar la conexión a la estación base provocará que esta no pueda ser suministrada.
En caso de romperse D2, R8, U1,4 o R10 producirá que no se genere el voltaje de referencia para la etapa 3. Provocando que el gate se mantenga apagado constantemente y el transistor de la etapa 4 solo dejara pasar la energía proveniente de VBat.
Se producirá un sobre voltaje en la pata 12 de U1,4 en caso de fallar D2 o R9. También provocando que haya un error en el voltaje de referencia de la etapa 3, siendo mucho mayor a lo requerido, provocando que el gate de la etapa 4 este siempre encendido y Q1 funcionando como un load-sharing normal.
Esto último también pasara en caso de fallar R11 o R12.
En caso de fallar C3, provocará que varíe de forma más rápida (de 1.28 a 1.32V) el voltaje que entra en la pata 12 de U1,4.

### 8.6. Tabla de fallas

Al describir que pasaría en caso de fallar los componentes, se puede realizar una tabla la cuál agrupara los componentes que fallen con sus respectivas consecuencias.
Además, usaremos un sistema de colores para catalogar las fallas, el cual se mostrara a continuación:
Admisible | Tolerable | inadmisible | Fatal

Cuadro 12: Descripción y prioridad.

Tipo de falla | Componente | Consecuencias
Cambió de Tensión | C1 C2 C3 | Cambió abrupto de voltaje durante el cambió de alimentación. Varia de forma más rápida (de 1.28 a 1.32V) el voltaje que entra en la pata 12 de U1,4.
Indicador de Alimentación | D2, R6 D3, R7 | Se pierde el indicativo de cuando se suministra mediante VBat. Ídem pero con VStep−Down.
Alimentación Externa | P2 (VWall), K1 (1, 4, 5 o 12) P1 (VPanel), K1 (3 o 4) D1 | La estación base y la carga de las baterías no pueda ser suminis-trada por VWall. Ídem por VPanel. La estación base sea alimentado solo por VBat.
Alimentación Interna | Q1 (Drain) Fallo CN3791 Baterías | La estación base solo puede sobrevivir de forma constante si esta funcionando VWall. Disminución de la capacidad y perdida de autonomía.
Comparación Histeresís | R5 | U1,2 funcionará como un comparador normal al perder la realimen-tación que produce la histeresís.
Comparación Gate Apagado | R1 U1,1, U1,3, U1,2 (6) Q1 (Gate) D2, R8, U1,4 o R10 | El voltaje del panel no podrá ser comparado en la etapa 3. El gate se mantenga apagado constantemente y solo se proveerá la energía mediante VBat. No se genera el voltaje de referencia para la etapa 3.
Comparación Load-Sharing Normal | R2 D2 o R9 R11 o R12 R3, R4, U1,2 (5 o 7), U1,3 (9) | Mala comparación en la etapa 3. Puede que el gate este casi siempre encendido. Error en el voltaje de referencia de la etapa 3, el gate esta siempre encendido y Q1 funcionando como un load-sharing nor-mal. Puede que el panel solar no proveerá suficiente corriente al superar VBat.
Sobre Voltaje | R2 D2 o R9 | Sobre tensión en la pata 6 de U1,2. Sobre voltaje en la pata 12 de U1,4.
Falla Fatal | Q1 (source) P3 (VEstacin−Base) K1 (4) | La estación base no podrá ser suministrada. Solo se podrá alimentar mediante VBat hasta que se le acabé la batería.

Cuadro 13: Tabla de componentes y sus consecuencias en caso de falla.

## 9. Circuito enfriador

Al cambiar de un CN3791 de 6V a uno de 12V trajo un problema, este siendo que se sobrecalienta al cargar las baterías. Por lo cual se diseño un circuito para enfriarlo al cargar las baterías utilizando un ventilado. Este circuito te puede ver a continuación:

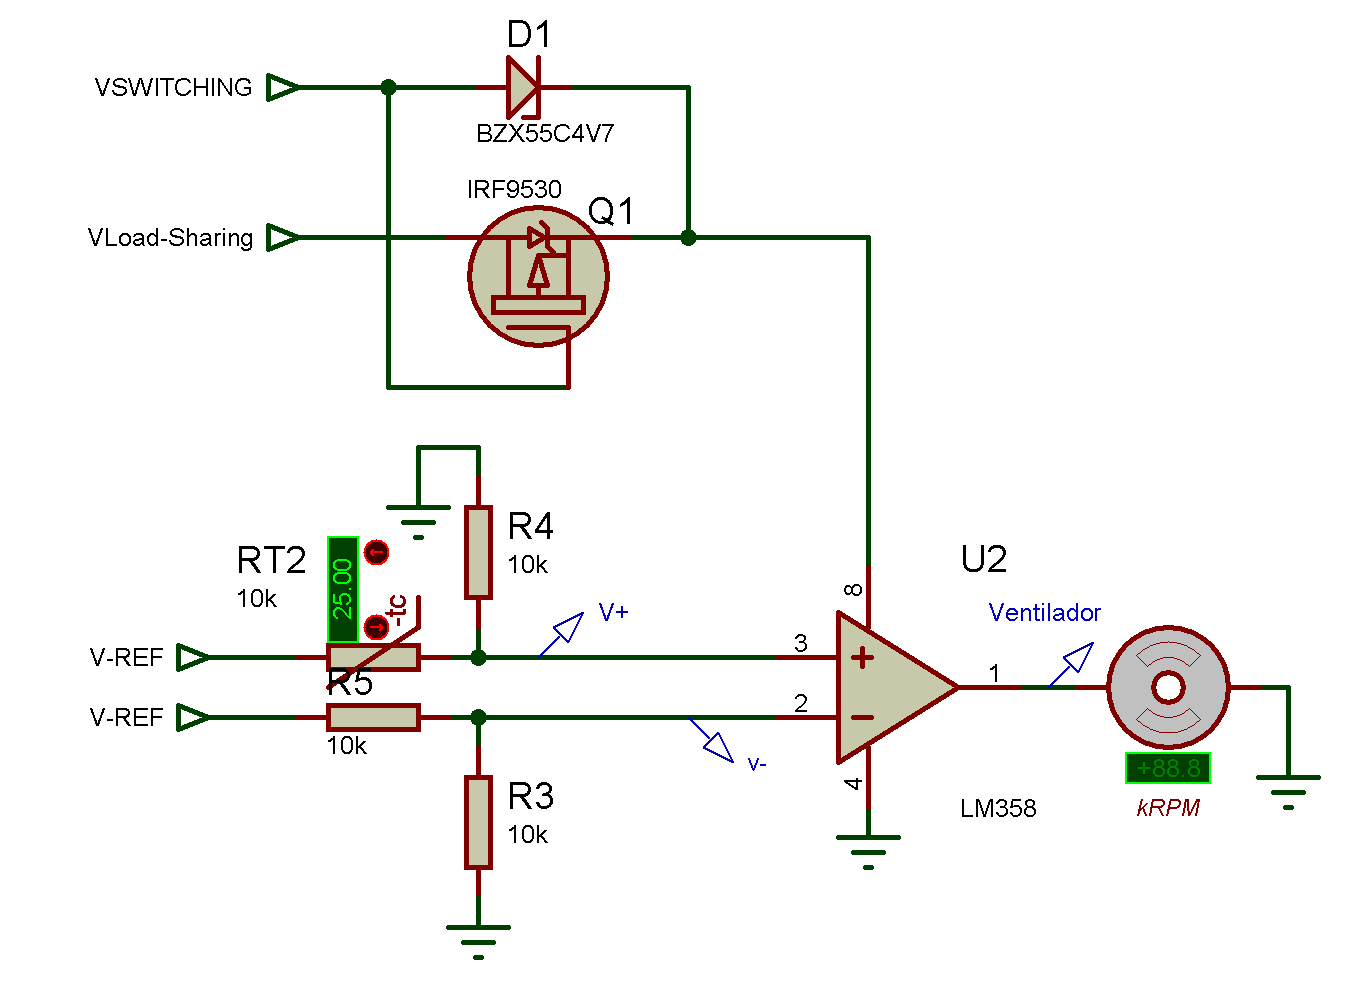
[picture p80: figure]

Figura 26: Esquemático del circuito enfriador.

Su funcionamiento es el siguiente, se utilizara un OpAmp para comparar dos señales, siendo ambas provenientes de divisores de tensión de V-Ref. El que entra a la pata V+, se compone por una resistencia que va a masa y un termistor NTC de 10kΩ a temperatura ambiente (25°C), el divisor de tensión será más grande mientras mayor temperatura haya, esto debido al comportamiento del termistor. En la pata V− se encuentra el otro divisor de tensión el cuál usaremos como referencia para encender el ventilador. Para modificar en que temperatura se encenderá el ventilador, se debe de modificar R5, en este caso se encendería a 25°C.

V+ =

VRefR4
R4 + RT2

V− =

VRefR3
R3 + R5
Condición de encendido del ventilador: V+ > V−.
Se utilizará un ventilador de 12V que comienza a funcionar a partir de los 6V. Para ello, el voltaje positivo del OpAmp viene de un Load-Sharing. La idea es que comience a funcionar cuando se esta cargando batería, o sea VSwitching > 11V. Pero VSwitching puede valer 0V, o ser menor que los voltajes de entrada V− y V+, lo que puede llevar a un mal funcionamiento del OpAmp. Por lo cual se agrega el voltaje de VLoad−Sharing, el cual siempre es mayor que los voltajes de entrada y se evita este problema, además que se cambiara el suministro de energía cuando VSwitching > VLoad−Sharing.

## 10. Bibliografía

### 10.1. Controlador

POWMR - PWM vs MPPT.¹⁸ (https://powmr.com/es/blogs/news/mppt-vs-pwm)

18https://powmr.com/es/blogs/news/mppt-vs-pwm

### 10.2. Componentes

Tempero Systems - HX-2S-01.¹⁹ (https://temperosystems.com.au/products/2s-5a-bms-hx-2s-01-li-ion-battery-protection-module/)

Youtube - Battery Management System (BMS) for a Lithium Ion Battery (with HX-2S-01).²⁰ (https://www.youtube.com/watch?v=xmq0hi3zTgQ&ab_channel=GemsungElectronics)

Electronic Linic - Battery Management System (BMS) for a Lithium Ion Battery (with HX-2S-01).²¹ (https://www.electroniclinic.com/bms-battery-management-system-explained/)

TP4056²² (https://www.instructables.com/Load-Sharing-Use-Solar-Panel-Safely-With-TP4056/)

Tindie - SOLAR CHARGER (con esquemático).²³ (https://www.tindie.com/products/iotmcu/super-mini-solar-lipo-charger-v10/)

Tindie - Demostración de Solar Charger.²⁴ (https://www.youtube.com/watch?v=gZnERtjM5PA&ab_channel=POWERGEN)

Mercado Libre - Cargador CN3719 (opciones de 6V, 9V y 12V).²⁵ (https://articulo.mercadolibre.com.ar/MLA-1106257985-cargador-bateria-lipo-uso-panel-solar-cn3791-arduino-elegir-_JM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)

Datasheet DSE-CN3065.²⁶ (https://make.net.za/product/cn3065-solar-lithium-charger-module/)

Make Electronics - CN3065.²⁷ (https://listado.mercadolibre.com.ar/dc-dc-boost)

Datasheet DSE-CN3791.²⁸ (https://www.laskakit.cz/user/related_files/dse-cn3791-2.pdf) Datasheet LM358.²⁹ (https://pdf1.alldatasheet.com/datasheet-pdf/view/1144175/KEXIN/LM358.html) Datasheet SRE-12VDC-SL-2C.³⁰ (https://www.radiolocman.com/datasheet/pdf.html?di=150193)

Datasheet LM2596.³¹ (https://pdf1.alldatasheet.es/datasheet-pdf/view/223022/ESTEK/LM2596.html)

Datasheet LM324.³² (https://pdf1.alldatasheet.es/datasheet-pdf/view/17871/PHILIPS/LM324.html)

Datasheet LM358.³³ (https://pdf1.alldatasheet.es/datasheet-pdf/view/3067/MOTOROLA/LM358.html)

Datasheet 1N5820.³⁴ (https://pdf1.alldatasheet.es/datasheet-pdf/view/201494/TSC/1N5820.html)

Datasheet 1N4007.³⁵ (https://pdf1.alldatasheet.es/datasheet-pdf/view/207678/PANJIT/1N4007.html)

Datasheet IRFZ44N.³⁶ (https://pdf1.alldatasheet.es/datasheet-pdf/view/17807/PHILIPS/IRFZ44N.html)

Datasheet IRF9530.³⁷ (https://pdf1.alldatasheet.es/datasheet-pdf/view/37028/SAMSUNG/IRF9530.html)

19https://temperosystems.com.au/products/2s-5a-bms-hx-2s-01-li-ion-battery-protection-module/20https://www.youtube.com/watch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 (https://articulo.mercadolibre.com.ar/MLA-1106257985-cargador-bateria-lipo-uso-panel-solar-cn3791-arduino-elegir-_JM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) 26https://make.net.za/product/cn3065-solar-lithium-charger-module/27https://listado.mercadolibre.com.ar/dc-dc-boost
28https://www.laskakit.cz/user/related_files/dse-cn3791-2.pdf29https://pdf1.alldatasheet.com/datasheet-pdf/view/1144175/KEXIN/LM358.html30https://www.radiolocman.com/d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

### 10.3. Final

Nomadas Electronicos - Load Sharing³⁸ (https://nomadaselectronicos.wordpress.com/2015/05/22/fuentecargador-con-carga-compartida-load-sharing/)

### 10.4. Circuitos

Histeresís - IDI Electrónica³⁹ (https://idielectronica.blogspot.com/2014/08/es-que-es-la-histeresis.html)

### 10.5. Diseño del circuito

La mayoría de las configuraciones de los amplificadores operacionales están extraídos de ’solución ingenieril’.⁴⁰ (https://solucioningenieril.com/asignaturas/amplificadores_operacionales)

Foro en el cual se trata el Load-Sharing - Stack Exchange.⁴¹ (https://electronics.stackexchange.com/questions/293353/load-sharing-charging-circuit-for-lithium-polymer)

Foro en el cual se trata el Load-Sharing - Stack Exchange.⁴² (https://electronics.stackexchange.com/questions/169611/solar-battery-charger-with-load-sharing)

Foro en el cual se trata el Load-Sharing - Blog Zakkemble.⁴³ (https://blog.zakkemble.net/a-lithium-battery-charger-with-load-sharing/)

Foro en el cual se trata el Load-Sharing con hysteresis - Arduino Forum.⁴⁴ (https://forum.arduino.cc/t/a-simplier-version-for-the-battery-charger-tp4056/1098526/23)

Carpeta en la cual un usuario del foro (Arduino Forum) trabajo sobre la implementación del Load-Sharing con hysteresis- GitHub.⁴⁵ (https://github.com/gbhug5a/Solar-Power-Load-Sharing)

Foro en el cual se trata el Load-Sharing con booster (falta revisarlo) - Arduino Forum.⁴⁶ (https://forum.arduino.cc/t/at-last-18650-charge-boost-module-with-load-sharing/1164462/16)

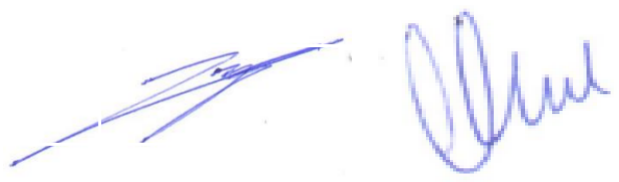
[picture p81: figure]

Mg. Ing. Jorge Cogo
Tutor CITTECA Sede Andina
DNI: 30.612.899

Ing. Denis Heredia

Tutor UNRN
DNI: 37.763.650

38https://nomadaselectronicos.wordpress.com/2015/05/22/fuentecargador-con-carga-compartida-load-sharing/39https://idielectronica.blogspot.com/2014/08/es-que-es-la-hist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
23 (https://forum.arduino.cc/t/a-simplier-version-for-the-battery-charger-tp4056/1098526/23)
45https://github.com/gbhug5a/Solar-Power-Load-Sharing46https://forum.arduino.cc/t/at-last-18650-charge-boost-module-with-load-sharing/1164462/16 (https://forum.arduino.cc/t/at-last-18650-charge-boost-module-with-load-sharing/1164462/16)
