Chamadreja/pps-solar-charger/investigacion/descargador_de_baterias/img/3d_1.png

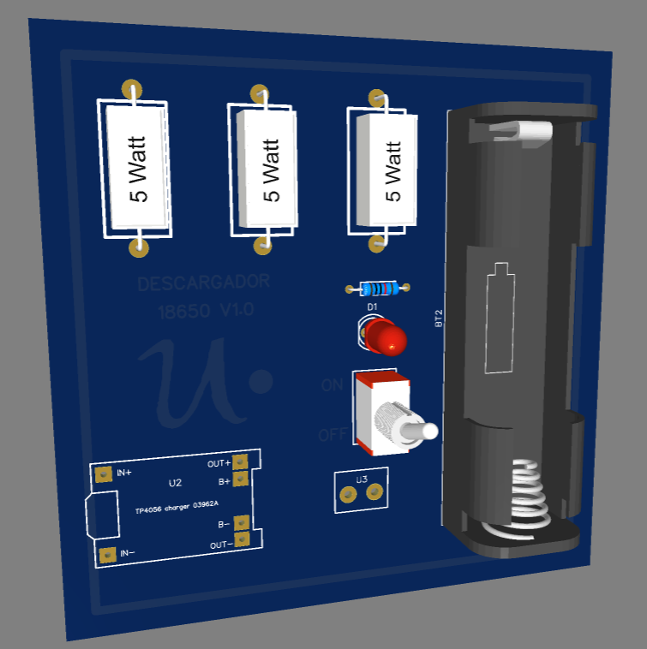
investigacion/descargador_de_baterias/img/3d_1.png
