Chamadreja/pps-solar-charger/investigacion/descargador_de_baterias/img/easy_eda_diseño.png

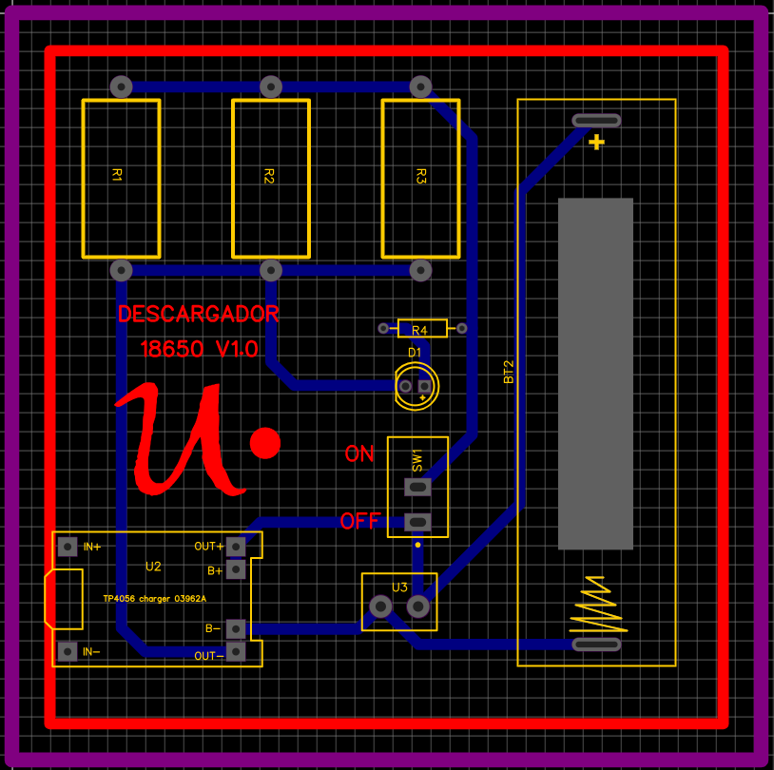
investigacion/descargador_de_baterias/img/easy_eda_diseño.png
