Chamadreja/pps-solar-charger/investigacion/descargador_de_baterias/img/PCB_PCB_Descargador_1_2024-03-31 (1).png

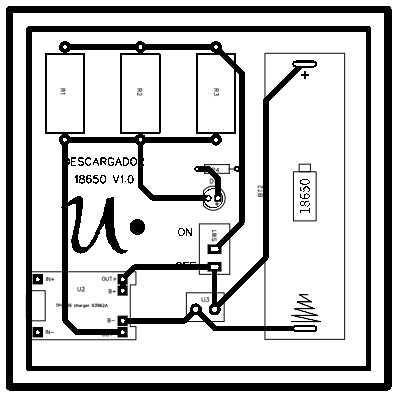
investigacion/descargador_de_baterias/img/PCB_PCB_Descargador_1_2024-03-31 (1).png
