Chamadreja/pps-solar-charger/proteus/Bloques.png

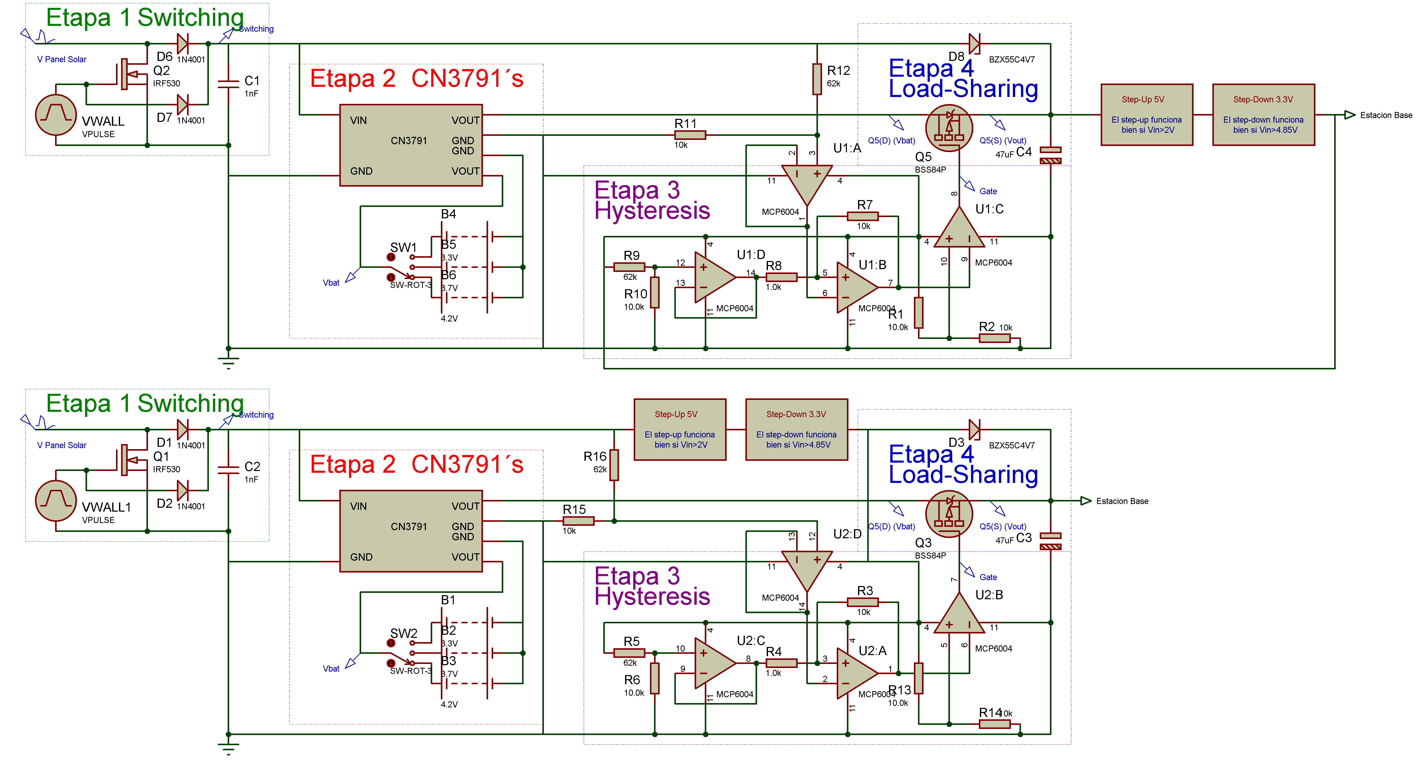
proteus/Bloques.png
