Chamadreja/pps-solar-charger/proteus/CargadorV1.4.png

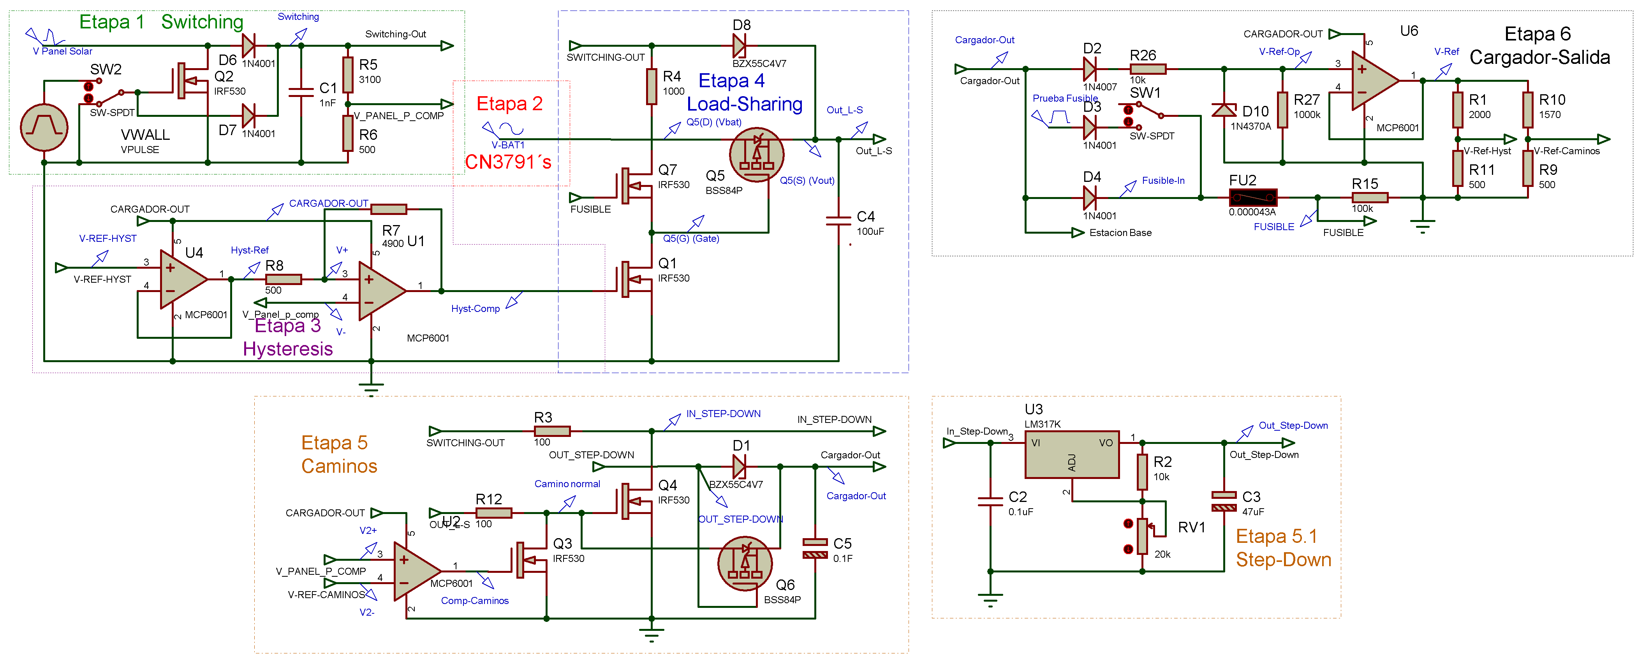
proteus/CargadorV1.4.png
