Chamadreja/pps-solar-charger/investigacion/descargador_de_baterias/design/18650discharger-main/badito_V5_BOM.xlsx

reference designator | Description |  | order EUR | order qty | order each | qty | shipping | shipping per unit | cost | stock | ordered
J1 | connector JST PH | https://www.aliexpress.com/item/4000036823994.html | 1.87 | 200 | 0.00935 | 1 | 1.44 | 0.0072 | 0.01655 | 120 | 0
R1, R2, R3, R4 | resistor power | https://www.aliexpress.com/item/1921263979.html | 0.49 | 10 | 0.049 | 4 | 1.9 | 0.76 | 0.956 | 19 | 10
LED | LED red 0603 | https://www.aliexpress.com/item/32947001269.html | 0.38 | 100 | 0.0038 | 1 | 1.07 | 0.0107 | 0.0145 | 0 | 100
X1 | terminal block 5.0mm P128-2p | https://www.aliexpress.com/item/32843866688.html | 1.44 | 20 | 0.072 | 1 | 2.94 | 0.147 | 0.219 | 5 | 20
BAT1 | battery holder | https://www.aliexpress.com/item/4001152338150.html | 0.28 | 1 | 0.28 | 1 | 1.09 | 1.09 | 1.37 | 4 | 6
M1 | TP4056 charger protected | https://www.aliexpress.com/item/1005001567784022.html | 1.74 | 10 | 0.174 | 1 | 1.09 | 0.109 | 0.283 | 20 | 0
S1 | rocker switch | https://www.aliexpress.com/item/32990004998.html | 0.35 | 10 | 0.035 | 1 | 1.78 | 0.178 | 0.213 | 8 | 10
PCB | PCB | https://jlcpcb.com/ | 4.15 | 10 | 0.415 | 1 | 10.91 | 1.091 | 1.506 | 3 | 10
n/a | rubber feet | https://www.aliexpress.com/item/32962698458.html | 1.63 | 40 | 0.04075 | 4 | 0.29 | 0.029 | 0.192 | 30 | 40
 |  |  |  |  |  | total euro |  |  | 4.77005
