Chamadreja/pps-solar-charger/investigacion/descargador_de_baterias/schematic/descargador_schem.pdf

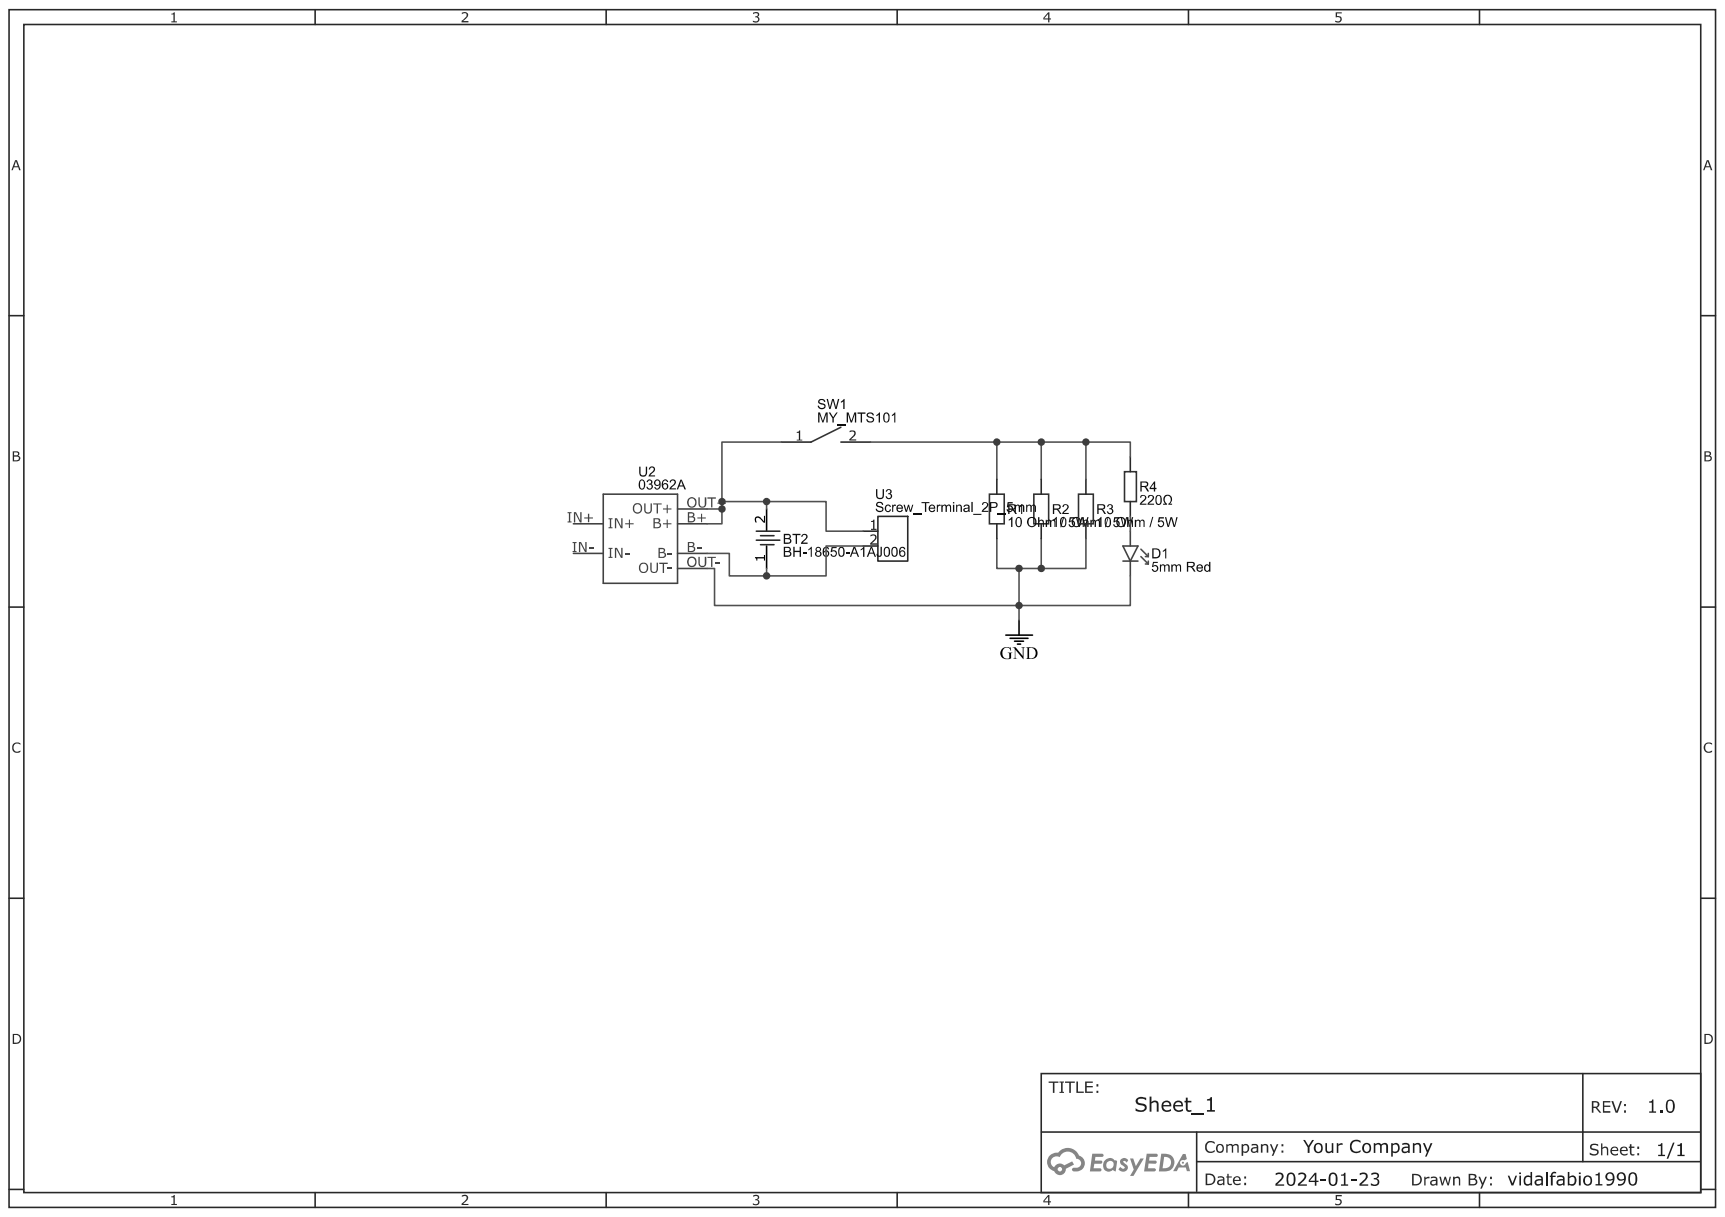
[picture p100: page 1]
