Chamadreja/pps-solar-charger/(list of files, drawings)

Other design files:
proteus/Cargador-CompletoV1.1.pdsprj
proteus/Cargador-CompletoV1.pdsprj
proteus/CargadorCompletoV1.2(Rele).pdsprj
proteus/CargadorCompletoV1.3(SchmittV3-3.3V-18V).pdsprj
proteus/CargadorCompletoV1.3-Bloques-V2.pdsprj
proteus/CargadorCompletoV1.4-Regulador-en-Salida_prueba3.pdsprj
proteus/CargadorCompletoV1.4d(bien)v2.pdsprj
proteus/CargadorV1.pdsprj
proteus/L-S-Estable-V1.pdsprj
proteus/L-S-Estable-V2-Prueba.pdsprj
proteus/L-S-Estable-V2.1-Prueba.pdsprj
proteus/Por etapas/Etapa-1.pdsprj
proteus/Por etapas/Etapa-3-1.pdsprj
proteus/Por etapas/Etapa-3-2.pdsprj
