Chamadreja/pps-solar-charger/investigacion/descargador_de_baterias/design/18650discharger-main/badito_V5.brd

## EAGLE design investigacion/descargador_de_baterias/design/18650discharger-main/badito_V5.brd (2025-12-18)

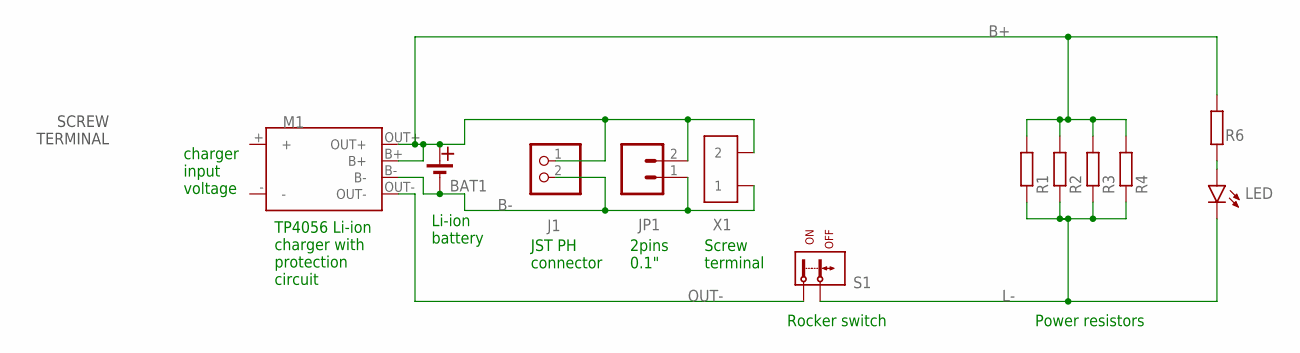
[picture p101: schematic badito_V5.sch]

Parts:
BAT1: KS18650X1-SMT
J1: JST_2PIN-SMT; JST-PH-2-SMT
JP1: 1X02_2.54MM_ROUND
LED: RED; LED-0603
M1: TP4056_CHG_PROT; BAT_CHG_PROT_BRD_27.9X17.4MM
R1, R2, R3, R4: R; R_PWR_CEMENT_10W
R6: 250R; R0603
S1: SWITCH_ROCKER_KCDI-101
X1: ED350/2

Connections:
B+: BAT1.+, J1.1 (2), JP1.2, M1.B+, M1.OUT+, R1.1 (2), R2.1 (2), R3.1 (2), R4.1 (2), R6.2, X1.P$2 (2)
B-: BAT1.-, J1.2 (1), JP1.1, M1.B-, X1.P$1 (1)
L-: LED.C, R1.2 (1), R2.2 (1), R3.2 (1), R4.2 (1), S1.2 (2.1), S1.2_2 (2.1)
unnamed: LED.A, R6.1
OUT-: M1.OUT-, S1.1 (1.1), S1.1_1 (1.1)

Notes on the sheet:
SCREW TERMINAL
TP4056 Li-ion charger with protection circuit
Rocker switch
Power resistors
Li-ion battery
JST PH connector
Screw terminal
2pins 0.1"
charger input voltage

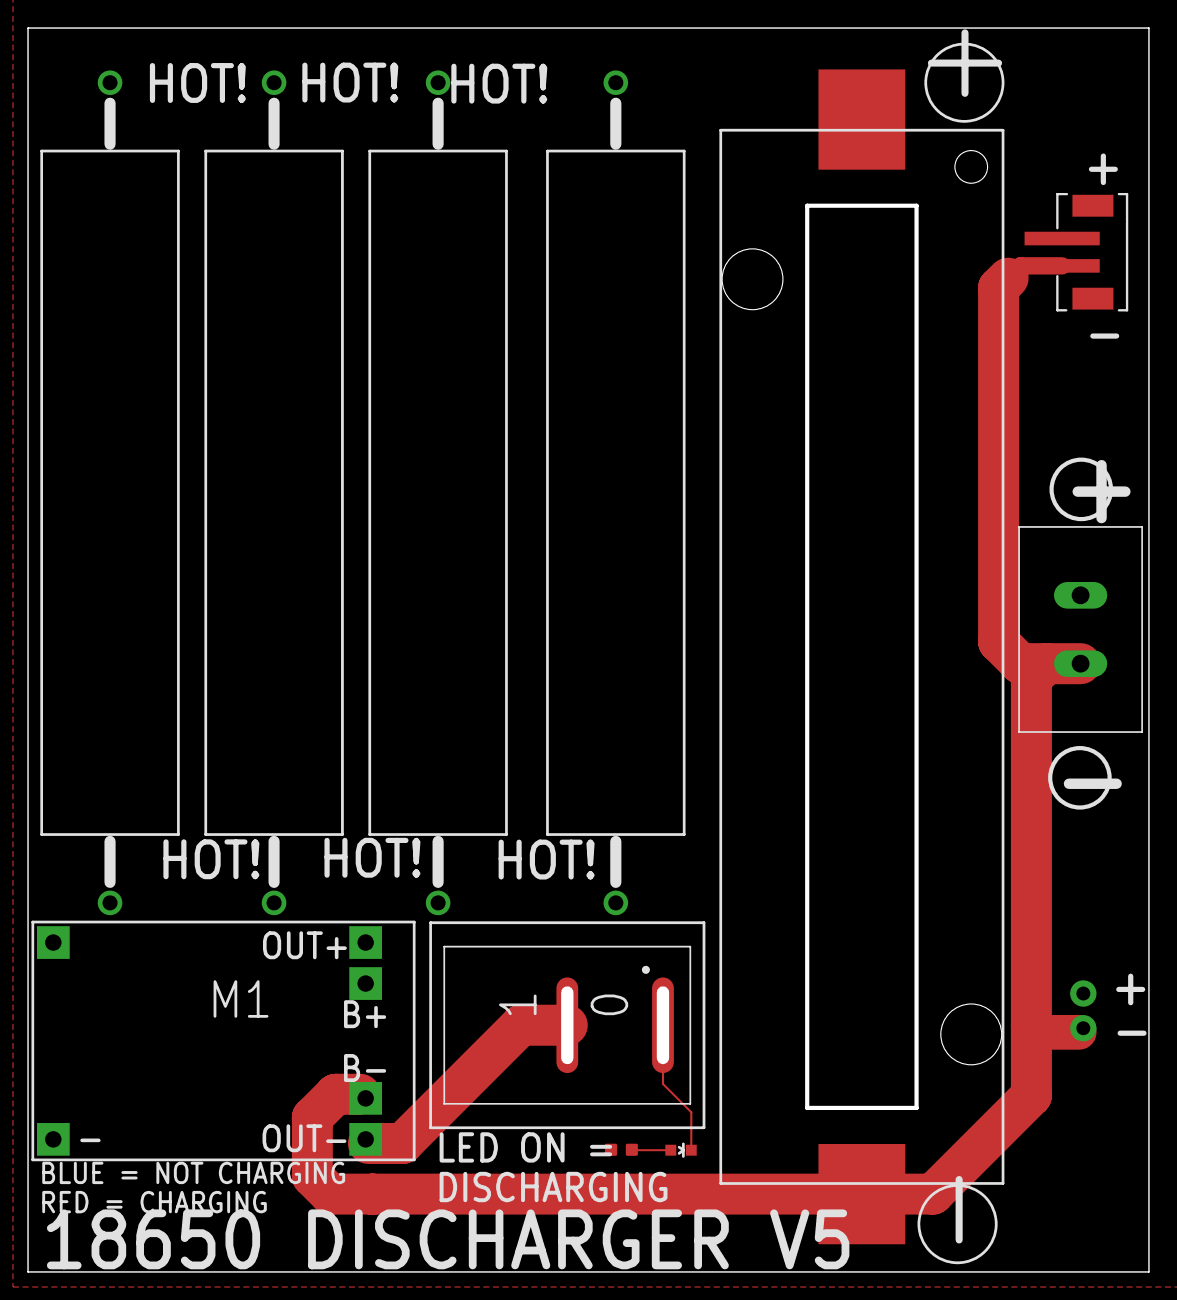
[picture p102: board badito_V5.brd from above]

Board: 2 copper layers, 82.0 x 91.0 mm, 12 parts (0 on the bottom side), 5 nets.
